harrisonhsueh/Buck_Boost_42W/uvlo/uvlo_latch.pdf

## UVLO Lockout Latch (rev. v3b): Discrete Pre-Bias Restart Protection for the LM5176 Buck-Boost

USB-C PD → 12 V Fan-Array Controller — Buck-Boost 42W

Abstract

A four-BJT + TLV431 latch that pulls the LM5176 EN/UVLO pin low on an input dropout and, because it is powered from VOUT , holds it low until the output has discharged (release at ≈1.0–1.8 V across unit tails), forcing every restart to begin from a nearly dead output. Rev. v3b uses a ratio-defined trigger — v3’s trigger depended on unspecified sub-threshold leakage; this one only on resistor ratios and spec’d VBE, so it is consistent across part spread. The SCR core is armed by a resistor divider (arm at 2.8 V nominal, i.e. box-center VBE; guaranteed range 2.0–3.6 V) and held off by an actively driven dearm transistor while the TLV431 senses a healthy input (dearm active from 2.05 V worst case, 27 mV of headroom above the 2.02 V physics floor). All device spreads are taken from the datasheet-box VBE model (traceable to the VBE(sat) spec), and the dearm-before-arm race is guaranteed by those spec limits alone at every temperature. Companion files: 10b uvlo latch.py (all checks below, executable), uvlo tlv431.tex/10a (EN/UVLO divider), simulation/en uvlo lockoutv3 tlv.asc.

## 1 Background

The LM5176’s pre-bias startup does not survive a brief input dropout in this design (deliberately slow control loop; TI support could not root-cause it). The latch disables the converter on dropout and re-enables it only once the output is discharged. Rev. v3 used Q3’s sub-threshold leakage as the engage seed; the required nA-level current is unspecified and spans orders of magnitude across the 2N3904 spread and temperature. v3b moves the trigger onto resistor ratios and spec’d VBE — robust and consistent by construction.

## 2 The VBE model (datasheet box, used everywhere below)

Anchor: the 2N3904/2N3906 VBE(sat) spec at IC = 10 mA, IB = 1 mA, 25 ◦C: 0.65 (min) .. 0.85 (max) V. The latch junctions operate near 30 µA, so the anchor is scaled by the diode law VBE = nVT ln(IC/IS) (n ≈ 1), whose difference form removes the unknown IS:

VBE(I1) − VBE(I2) = VT ln I1
I2

⇒ ∆VBE = 25.9 mV · ln 10 mA 30 µA

= 25.9 × 5.81 = 150 mV,

V

lo

BE(30 µA) = 0.65 − 0.15 = 0.50 V, V hi BE(30 µA) = 0.85 − 0.15 = 0.70 V (25 ◦C),

with the −2 mV/

◦C tempco applied for temperature (0–50 ◦C design range: e.g. V
hi
BE(0 ) = 0.75,
V

lo
BE(50 ) = 0.45). Conservatism note: VBE(sat) is a saturation measurement (both junctions forward, base overdriven) and includes the ohmic drop rbIB — small-signal base spreading resistance is typically rb ≈ 10–100 Ω, i.e. 10–100 mV at the IB = 1 mA test condition — neither of which exists at 30 µA. The true active-mode box is therefore narrower; using the spec box as-is is the safe, traceable reading.
Other model values: VCE,sat = 0.1 (max 0.2) V; βmin = 30; V

off
BE = 0.4 V (design bound; “off” is defined quantitatively in step 2 — leak ≪ hold drive — not as zero); VKA = 1.24 (max 1.27) V — the latch’s worst case is the max, since it sets the dearm floor; the corresponding min is 1.193 V once the full onsemi VKA excursion is folded in (uvlo tlv431.tex), which is what the divider search uses; TLV431 (onsemi): IK(off) ≤ 0.05 µA, I

reg
KA 30 µA typ / 80 µA max, I

max
K = 20 mA;
resistors ±3% (1% purchase + 100 ppm/

◦C tempco + load-life/soldering drift); VOUT = 12 nom / 15.75 max (15 V zener +5%); V

max
IN = 22 V. EN/UVLO divider (sized in uvlo tlv431.tex): R2/R1a/R1b = 420/150/15 kΩ.

## 3 Circuit and chosen values


The latch is the left block; the EN/UVLO divider it senses (and clamps) is on the right, sized in uvlo tlv431.tex.

Ref | Value (bound → chosen) | Connection | Role
Q1 | 2N3904 | c: EN/UVLO, b: N5, e: GND | EN clamp
Q2 | 2N3906 | e: VOUT , b: VB2, c: N1 | dearm driver
Q3 | 2N3904 | c: N4, b: VB3, e: GND | core NPN (armed switch)
Q4 | 2N3906 | e: VOUT , b: VB4, c: VB1 | core PNP
R3 | race-solved ≤ 135k → 130 kΩ | VB3–GND | arm divider bottom
R4 | 300 kΩ (free choice) | VOUT –VB3 | arm top / Q3 drive
R5 | ≥ 51R6 → 82 kΩ | VB4–N4 | Q3 pulls Q4 base
R6 | 1 kΩ | N1–VB4 | Q2 pulls Q4 base up
R7 | 30 kΩ | VB1–VB3 | regeneration
R8 | tier choice (step 2) → 2 MΩ | K–GND | TLV431 cathode load
R9 | window (step 1) → 1.5 kΩ = 2×3 kΩ ∥ (0603 pair) VB2–K | Q2 base ← cathode
R10 | ≤∼ 49k solved (step 2) → 47 kΩ | VOUT –VB2 | Q2 base pull-up
R11 | 100 kΩ | N5–GND | Q1 base divider bottom
R12 | 100 kΩ | VB1–N5 | Q1 base divider top
U1 | TLV431 (onsemi only) | A: GND, K, REF: divider VREF | sensor

Q3/Q4 with R5/R7 form the two-transistor SCR; Q1’s base is driven from Q4’s collector through
R12/R11, so before the latch fires its base sits at a defined sub-threshold level (0.33 V, Stage 4) rather than floating on leakage.

## 4 Design walkthrough (sizing order, worked numbers)

### 4.1 Stage 1: R10, R9, R8 — TLV431 sensing and the Q2 dearm driver

Constraint set. With the TLV431 regulating (K clamped at VKA), Q2’s base drive is

| IB2 = VOUT − VKA − VEB2
| R9

−

| VEB2
| R10

≥ I

req
B2 ≈ 1.1 µA | ⇐⇒ | R10 ≥
| | VEB2 R9
| | h − R9 I req
| | B2
| | , | (1)

with h = VOUT − V

| max
KA − VEB2 the drive headroom; and with the TLV431 off,
| V res
| EB2 = V max
| OUT R10
| R8 + R9 + R10 | + IK(off)R10 ≤ V off
| | BE = 0.4 V. | (2)

With VEB2 = V

| hi BE(0 ) = 0.75 V, the physics floor is V

max
| | KA + VEB2 = 1.27 + 0.75 = 2.02 V.
Step 1: R9 from its independent bounds. R9 carries the full cathode current whenever the converter runs, IK = (VOUT − VEB2 − VKA)/R9, which is also the TLV431 regulation current:

IK ≤ 20 mA at 15.75 V : R9 ≥

| 13.81
20m = 0.69 kΩ; | IKA ≥ 80 µA at the box worst-low arm (1.98 V, step 3) : R9 ≤

Power: a single 0805 would demand R9 ≥ 13.81²/0.125 = 1.53 kΩ, above the IKA bound: no single resistor works. Build R9 = 1.5 kΩ as two 3 kΩ basic 0603s in parallel — each part carries half the current (34 mW continuous / 64 mW at the OV corner vs. 100 mW rating). IKA razor: even 1.5 k reads 61 µA nominal / 59 µA at R9+3% at the box-corner arm point vs the 80 µA max-of-min — reaching spec would need R9 ≤ 1.1 k, i.e. a 4-resistor array. Accepted: the shortfall exists only at the full R-corner + hot + low-tail stack, fails soft (under-regulation raises K while VOUT and IKA keep rising), and typical parts need 30 µA. Bench item for the startup ramp. Why not smaller R9 (the headroom question):

R9 | dearm active | IK@12 V | IK@15.75 V | PR9 tot @12/15.75 V | verdict
1.5 k (2×3k∥) | 2.047 V | 6.7 mA | 9.2 mA | 67/127 mW (34/64 per part) chosen
1.0 k (2×2k∥) | 2.038 V | 10.1 mA | 13.8 mA | 101/191 mW | buys 9 mV, IKA 91 µA
0.5 k | 2.029 V | 20.1 mA | 27.6 mA | 202/381 mW | exceeds 20 mA rating
0.1 k | 2.022 V | 101 mA | 138 mA | 1.0/1.9W | 7× over rating
Step 2: pick the R8 tier, then SOLVE Rmax
10 from (2). (1) and (2) pull R10 oppositely: larger R10 lowers the dearm point (less bleed) but inflates the off-state residual, bought back with larger R8. The leakage term alone would allow R10 up to 0.4/0.05 µA = 8 MΩ — nowhere near binding; the divider term of (2) is what sets the bound. Basic-part R8 above 510 k comes only in 1 M, 2 M, 10 M, so fix the tier and solve for R10 (corners R10+3%, R8, R9−3%):
R8 tier | Rmax
10 | solved | basic pick | dearm active | hot ICBO(100 nA)·R10
2 M | ∼49 kΩ | 47 k | 2.047 V | 4.7 mV
10 M | ∼230 kΩ | 220 k | 2.027 V | 22 mV

With IK(off) = 50 nA the leakage term is negligible (47k×50 nA = 2.4 mV); the bound is the divider alone. The 10 M tier buys 20 mV (asymptote 2.02 V) while quintupling ICBO/board-leakage sensi-tivity — rejected. Chosen: R8 = 2 MΩ, R10 = 47 kΩ. Verify (2) at corners (R10+3%, R8, R9−3%): 15.75 ·

48.4k
1.99M + 50n · 47k = 0.383 + 0.002 = 0.386 V ≤ 0.40 V ✓. What “off ” means, quantitatively: at that residual, a box-worst (low-tail, 50 ◦C) Q2 still leaks IC2 = 30 µA · e

(0.386−0.45)/VT = 3.0 µA
— but the latch’s VB4 hold drive at the same corner is 183 µA, so the leak is 1.6% of the hold: “off” means negligible against the hold, not zero. The resulting worst-case dearm-active point: bleed = 0.75/45.6k = 16.4 µA, h = 1.545k · (16.4+1.1) µA = 27 mV ⇒ VOUT = 2.05 V (a solved result, not a target; its only requirement is the race, step 3).

### 4.2 Stage 2 (step 3): R4, R3 — the arm threshold and the race

With Q4 off, VB3 is loaded by R3 ∥ (R7+R12+R11): Reff
| | | 3 | = 130∥230 = 83.1 kΩ, so
Varm = VBE(︂ 1+ | R4
| Reff
| 3

)︂
: | V
| mid
arm = 0.60·4.61 = 2.77 V, | V min
arm = 0.45·4.40 = 1.98 V, | V max
arm = 0.75·4.84 = 3.63 V,

(3)
the ratio 1 + R4/Reff
3 being evaluated at the ±3% resistor corners (4.40 / 4.61 / 4.84). R3 is solved from the race requirement: dearm-active(T) ≤ V

min
arm (T) at every temperature, with Q2 at the box high tail and Q3 at the box low tail simultaneously. The binding corner is 50 ◦C: V

min
arm ≥ 1.27 + V

hi
BE(50) + h = 1.94 V ⇒ R3 ≤ 135 kΩ → 130 kΩ basic. Margins:

race margin = V

min
arm (T) − dearm(T) = 374 mV (0 ), 205 mV (25 ), 37 mV (50 binding).

Guaranteed by the datasheet box alone — no unit screening required. Q3 drive once armed: IB3 = (VOUT − Varm)/R4 ≈ (12 − 2.77)/300k = 31 µA against the 142 µA dearm-chain load: forced β = 4.6 ≤ 10.

### 4.3 Stage 3 (step 4): R5, R6, R7 — the VB4 fight and regeneration

Dearmed (Q2 and Q3 both on): the chain VOUT → Q2 → R6 → R5 → Q3 →GND carries I = (VOUT −2VCE)/(R5+R6); VB4 sits below VOUT by VCE2+IR6. At 15.75 V: I = 15.55/83k = 187 µA, so VOUT − VB4 = 0.1 + 0.187 = 0.29 V ≤ 0.40 V ✓(this is where R5 ≥ 51R6 comes from). Latched at the 2 V hold floor (cold tails: drive junctions at V

hi
BE(0) = 0.75, loads at V

lo
BE(0) = 0.55):
IB4 = (2−0.75−0.1)/82k = 14.0 µA; IC4 = (1.9−0.55)(1/30k+1/100k) = 58.5 µA: forced β = 4.2. Regeneration: IB3 = (1.9−0.75)/30k + (2−0.75)/300k − 0.75/130k = 38.3+4.2−5.8 = 36.7 µA against a 14 µA load.

### 4.4 Stage 4 (step 5): R12, R11 — the Q1 EN clamp

Off before the latch fires: VN5 = V

hi
BE(0)·R11/(R7+R12+R11) = 0.75·100/230 = 0.33 V, below even a hot low-tail unit’s 0.45 V conduction. Clamp at the 2 V hold floor: IB1 = (1.9 − 0.75)/100k − 0.75/100k = 4.0 µA against the requirement IEN /βmin = 57.6 µA/30 = 1.9 µA: margin 2.1×. Release, solving IB1 = IEN /β:

V

rel

OUT = VCE4 + VBE + R12(︂IEN
β

+

VBE

R11

)︂
= 1.05 V (V

lo
BE, VIN =6) . . . 1.79 V (V

hi
BE, VIN =22). (4)

Hold guaranteed at 2.0 V; actual release 1.0–1.8 V by unit; the SCR core itself un-latches near 0.8 V.

## 5 Operating sequence (summary)

1. Cold start: VOUT = 0, latch unpowered, Q1 base defined low.
2. VOUT rises: dearm active from 2.05 V (worst), arm at 2.0–3.6 V; dearm wins by ≥37 mV at any single temperature, guaranteed by the datasheet box.
3. Dropout with VOUT > Varm: TLV off → Q2 off → Q3 wins VB4 → Q4 on → Q1 clamps EN; R7 regenerates.
4. EN low ⇒ VREF ≤ 0.19 V ≪ VTLV: hold is VIN -proof.
5. VOUT decays; EN releases at 1.0–1.8 V; clean restart.

Accepted gap. A dropout while VOUT is between release (1.0–1.8 V) and that unit’s arm point (2.0–3.6 V) does not latch. More precisely: the latch cannot act anywhere below its arm point, so the unprotected region is VOUT < Varm — it extends down to zero, not merely to the release point. (The release point governs when an already engaged latch lets go; it is not a lower bound on the exposure.)
Two qualifications matter. First, body diodes do not bound it: the LM5176 switches syn-chronously, so an enabled FET conducts in either direction. Second — and this is the part that makes the exposure a safety question — a stored-energy argument does not bound it. A passive dump through a conducting FET would simply equalise the two banks at VOUT COUT /(COUT+CIN ) = 3.56 V, which is harmless. But a buck-boost transfers energy through its inductor, and the input bank is 90× smaller (COUT ≈ 18.9 mF vs. CIN ≈ 0.21 mF), so any reverse transfer is a boost into a small capacitor:
VIN ≈ VOUT√︃
COUT

CIN

= 3.6 × 9.5 ≈ 34 V, | (5)

against a 22 V operating maximum and 35 V input electrolytics — with the attached USB source seeing the same rail. Even a quarter of the energy arriving gives ≈ 17 V.
Open item (safety). Confirm by bench and simulation that the LM5176’s pre-biased startup performs no reverse energy transfer for VOUT below the arm point. Until that is shown the low-VOUT band is an accepted, documented exposure; the case for extending protection below the arm point — or for clamping the input — rests on that measurement.

## 6 TLV431 vendor constraint

Eliminating the resistors from (1)/(2) gives the floor V

worst
K | ≥ V

max
OUT −

V

off
BE
VEB2

(Vdearm − VKA) =
15.75 −

0.4
0.75 (2.05 − 1.24) = 15.3 V; the chosen divider gives 15.75 · 2M/2.05M = 15.4 V. Holding VK ≤ 6 V is therefore impossible at any useful dearm point, which is why the design assumes the onsemi TLV431 (V

max
KA = 16 V) rather than the pin-compatible TI part. The 15.4 V figure is itself a double-fault corner: K only floats high while the latch is engaged, and in that state VOUT is decaying from ≈12.6 V, giving a realistic VK ≈ 12.4 V.

## 7 Quiescent draw

Dearmed at 12 V: R9 chain 12−0.7−1.24
1.5k = 6.7 mA + R10 15 µA + R5+R6 142 µA + R4 31 µA ≈ 6.9 mA (≈ 83 mW). Each 3 k of the R9 pair dissipates 34 mW continuous / 64 mW at the OV corner (0603-safe). This is the price of the 2.05 V dearm point.

## 8 Verification status

10b uvlo latch.py runs the above as 21 worst-case checks: 0 FAIL, 2 WARN (the 59–61 µA IKA razor of step 1, and the onsemi-only vendor note), and parses the latest .raw.
The current LTspice transient (schematic at R3 = 130k, R5 = 82k, R8 = 2M, R9 = 2.2k, R10 = 39k, EN/UVLO divider already at the recommended 420/150/15 kΩ, plus a behavioural EN-pin current source: 0.2 µA below threshold, 3.15 µA enabled) confirms the full sequence:
- Arm: VB3 clamps at 0.64 V — Q3 on, core armed.
- Engage: EN clamps at VIN = 3.47 V vs. 3.51 V predicted from the divider equation at VTLV = 1.24, IS = 3.15 µA (1.3 % error).
- Hold: EN ≤ 10 mV through a full VIN re-application at VOUT = 12 V.
- Release: at VOUT = 1.08 V, inside the predicted 1.0–1.8 V band.
- Dearmed: VREF = 1.88 V while running (> VTLV = 1.24 V), i.e. the TLV431 conducts throughout normal operation as C2/C3 require.
The simulated circuit still carries two intermediate values, R9 = 2.2 kΩ (vs. the 1.5 kΩ of the 2×3 k pair) and R10 = 39 kΩ (vs. 47 kΩ). Both final values only lower the worst-case dearm point (2.09 → 2.05 V), so the sequence above is representative of the final design.
