harrisonhsueh/Buck_Boost_42W/uvlo/uvlo_tlv431.pdf

## LM5176 EN/UVLO Threshold with TLV431 Latch: Equations, Ranges, and Design Constraints

USB-C PD → 12 V Fan-Array Controller — Buck-Boost 42W

Abstract

This document derives the equations and worst-case design constraints for the three-resistor EN/UVLO divider that feeds both the LM5176 enable pin and the TLV431 reference of the external lockout latch. It is the analytical companion to 10a uvlo resistor search.py, which searches stocked resistor values against these constraints. The latch circuit itself is documented in uvlo latch.tex / 10b uvlo latch.py.
Result: R2/R1a/R1b = 420/150/15 kΩ (R2 = 120 k + 300 k in series), guaranteed turn-on band 2.75–4.49 V, per-unit gaps 52/41 mV.

## 1 Motivation: why an external lockout latch

The LM5176 advertises pre-biased startup, but in this design it does not survive an input dropout in practice. The control loop is deliberately slow (low crossover frequency, chosen so the loop does not react to the fan commutation pulses — see the stability notebook), and with that loop the part misbehaves when VIN recovers while the output capacitors are still charged: the restart into a pre-biased output is not handled cleanly. TI support was unable to root-cause the failure; their only suggestion was to raise the crossover frequency, which is ruled out by the system requirement that set the low crossover in the first place — the loop must not chase the fan commutation pulses, so raising its bandwidth would trade one problem for another.
The chosen fix is a small discrete latch: on an input dropout it pulls EN/UVLO low and, because it is powered from VOUT , it holds EN/UVLO low until the output has actually discharged. Every restart therefore begins from a nearly dead output and the pre-bias path is never exercised. This document sizes the divider that tells the latch when to fire; the latch itself is in uvlo latch.tex.

## 2 Circuit topology and conventions

A single node, EN/UVLO (voltage VEN), is driven from VIN through R2. A two–element lower leg returns to ground: R1b connects EN/UVLO to the TLV431 reference node (voltage VREF), and R1a connects that reference node to ground. The TLV431 REF pin sits on the VREF node and draws a bias current Iref into the pin.


(Left block: the lockout latch of uvlo latch.tex; right: the R2/R1b/R1a divider on the EN/UVLO pin with the behavioural EN-current source used in simulation.)

Current–source convention (LM5176). Per the datasheet, the LM5176 sources current out of the EN/UVLO pin into the node: ISTBY in standby, plus an additional IHYS once the operating (UVLO) threshold is crossed, which lifts VEN and creates the turn-on/turn-off hysteresis. The total injected current is

IS = ISTBY + IH, IH =

{︄
| | 0 | standby (rising, before turn-on)
| | IHYS | running (after turn-on)

## 3 Parameter ranges

Symbol | Min | Max | Notes
VIN | 4.5 V | 22 V | USB input
VEN,th (operating) | 1.17 V | 1.29 V | LM5176 EN/UVLO operating threshold
ISTBY | 1 µA | 3 µA | standby source current
IHYS | 2.15 µA | 4.25 µA | added after turn-on
Iref | 0 µA | 0.38 µA | TLV431 REF input current
VTLV | 1.193 V | 1.266 V | effective TLV431 reference (see below)
Resistors | ±3% | budget-derived; see below

Effective TLV431 reference VTLV. Built up from the nominal 1.24 V:

V

max
TLV = 1.240 + 0.0062
⏞ ⏟⏟ ⏞
+0.5%

+ 0.020
⏞ ⏟⏟ ⏞
temp

= 1.266 V, V min
TLV = 1.240 − 0.0062
| | | ⏞ ⏟⏟ ⏞ −0.5% − 0.020 ⏞ ⏟⏟ ⏞ temp − 0.021 ⏞ ⏟⏟ ⏞ VKA effect = 1.193 V.

The VKA term uses the datasheet reference shift ≈ −1.5 mV/V across the cathode excursion. The cathode floats to ≈ 15.4 V once the latch fires (see uvlo latch.tex), so the shift spans 1.24 →

15.4 V: 1.5 mV/V × 14.2 V ≈ 21 mV. The term only shifts the reference down, so it appears in the min only.
This excursion also drove the choice of vendor: the reference sees the full ≈ 15.4 V on its cathode whenever the latch is engaged, so a part rated to only 6 V on VKA (the TI TLV431) would be outside its absolute maximum in normal operation of this circuit. The onsemi TLV431, rated 16 V, is the part assumed throughout — the two are otherwise pin- and function-compatible, which makes this an easy substitution to get wrong.

Resistor tolerance budget. ±3% everywhere: 1% purchase tolerance + ∼0.4% tempco (100 ppm/

◦C
over the 0–50◦C range) + ∼1.5% load-life and soldering drift.

## 4 Node equations (KCL)

EN/UVLO node.
VIN − VEN
R2

+ IS =

VEN − VREF

R1b

(1)

REF node.
VEN − VREF

R1b

=

VREF

R1a

+ Iref | (2)

## 5 Closed-form solutions

Solving (1)–(2):

VEN =

VIN (R1a + R1b) + IS R2(R1a + R1b) − Iref R1a R2
R1a + R1b + R2

(3)

VREF =

R1a (VEN − Iref R1b)

R1a + R1b

(4)

TLV431 trip relation (the key design lever). The map between VEN and VREF depends only on the lower leg, independent of VIN , R2, and the EN-pin currents:

VEN = VREF

R1a + R1b

R1a

+ Iref R1b | =⇒ | VEN

⃓
⃓

trip = VTLV

R1a + R1b

R1a

+ Iref R1b | (5)

at the instant VREF = VTLV.

Inverting (3) for VIN . For any target VEN in a given state,

VIN =

VEN(R1a + R1b + R2) − IS R2(R1a + R1b) + Iref R1a R2

| | R1a + R1b
. | (6)

## 6 Latch behavior and the three threshold events

The external latch is powered from VOUT and defaults to engaged: it is held off (dearmed) only while VREF > VTLV. There is no “arm-after-first-release” grace — whenever VREF sits below VTLV with the converter running and VOUT above the latch’s arm threshold (≈ 2.8 V nominal; see uvlo latch.tex), the latch grabs and pulls EN/UVLO low, holding until VOUT has decayed (≈1–1.8 V release). The divider must therefore keep the TLV431 conducting throughout normal operation.
1. VIN rises; VEN (standby, IS = ISTBY) reaches VEN,th: LM5176 turns on.
2. IHYS switches in ⇒ VEN, hence VREF, jumps up. Because the design forces Vlatch < Von (constraint C2), VREF is already above VTLV at this instant: the latch is dearmed at turn-on, even on an arbitrarily slow rise.
3. VIN falls. While running, VREF falls; when it drops below VTLV the latch engages before the LM5176 would reach VEN,th on its own (constraint C3).

Event definitions. All three events are values of VIN , each defined by (6) with the VEN level and EN-pin current of its own operating state:

Event | VIN at which. . . | IS | state
Von | VEN = VEN,th | ISTBY | standby, rising (turn-on)
Vlatch | VEN = VEN|trip | ISTBY + IHYS | running, falling (TLV431 trip)
Voff | VEN = VEN,th | ISTBY + IHYS | running, falling (LM5176 self-dropout)

The required ordering, for every individual unit, is

Voff < Vlatch < Von. | (7)

Note the chain deliberately mixes states: Von uses the standby current because that is the state the part is actually in as VIN rises; the moment the threshold is crossed, IHYS engages and VEN jumps upward (the equivalent running-state crossing is Voff, lower by the hysteresis), so comparing Vlatch (a running event) against the standby Von is the correct and conservative form for the turn-on race.

Equivalent chain in VREF. Because running-state VREF is monotonic in VIN , (7) is equivalent to bracketing the TLV431 reference between the running-state VREF levels at the two LM5176 events:

R1a(VEN,th − IrefR1b)

R1a + R1b
⏞ | ⏟⏟ | ⏞
| V run
REF at Voff

< VTLV < V run
REF at Von, | (8)

i.e. the TLV431 must still be conducting when the LM5176 would drop out (left), and must be conducting from the moment IHYS engages at turn-on (right) — the requirement begins once IHYS lifts the running-state VREF, which happens as (or just before) the converter starts switching.

## 7 Design constraints (worst case)

Each must hold across the ±3% resistor tolerance and every chip-parameter extreme of the table above.

C1 — Guaranteed turn-on by 4.5 V. In standby,

min VEN(︁
VIN =4.5, IS=I

min

STBY, Imax
ref )︁
≥ V

max
EN,th = 1.29 V. | (9)

C2 — Latch dearmed below turn-on (per-unit).

min
corners

(︁

Von − Vlatch)︁
≥ 0. | (10)

We require Von > Vlatch so that no band exists in which the converter runs while VREF < VTLV (such a band would let the default-engaged latch grab during a slow start). Like C3, (10) is a per-unit (correlated) difference — evaluated as one subtraction per device, never as a gap between independent population bands (Section 8).

C3 — Latch fires before the LM5176’s own UVLO (per-unit).

min
corners

(︁

Vlatch − Voff)︁
≥ 0. | (11)

C4 — Do not turn on too early. The worst-case earliest turn-on must stay above V

min
on ≥
2.5 V, so a not-yet-settled USB rail is not loaded and the converter is not asked to boost from an impractically low input. C4 fights C2: the large R2 that C2 demands, together with the 1 µA to 3 µA spread of ISTBY, smears turn-on across a ∼1.5 V band and drags the earliest turn-on down.

The hysteresis budget links C2 and C3. From (6), ∂VIN /∂IS = −R2 exactly, so the two VEN = VEN,th crossings, whose currents differ by IHYS, are separated by

Von − Voff = IHYS R2. | (12)

Subtracting (Vlatch − Voff) from both sides,

(︁

Von − Vlatch)︁
= IHYSR2 −

(︁

Vlatch − Voff)︁
(13)

— the two gaps share the single budget IHYSR2. A larger R2 widens the budget, and the VEN,th (±60 mV) and VTLV (+26/ − 47 mV about 1.24 V) spreads inflate the worst-case (Vlatch − Voff) gap by the factor (R1a + R1b + R2)/(R1a + R1b) (Section 8, Eq. (17)). Fitting that inflated gap inside the budget while leaving (Von − Vlatch) ≥ 0 is what forces R2 large — and a large R2 means a low, soft turn-on with divider current sinking toward the EN bias currents. The search rejects the bias-dominated region (divider current at turn-on below the total EN bias current) because there VEN becomes dominated by ISTBY/IHYS — currents with wide spec spreads and no drift specification — so the thresholds would smear with current spread rather than track VIN . The net effect is that all four constraints together are satisfiable only in a narrow design band — a real consequence of the part tolerances, not a modelling artifact.

Worked result (±3%, corrected V

min
TLV). Restricting the search to JLCPCB basic-part 0603 values, no triple of single stocked resistors clears all four constraints. Allowing R2 to be a series pair of two basic parts (one extra placement, still no extended-part fee) yields 19 passing triples. Selection criterion: the per-unit gaps are guaranteed positive by construction and need no extra margin, so among passing triples the search prefers the highest worst-case earliest turn-on V
| min on

— a higher Von floor eases the downstream latch’s dearm-before-arm race (SORT MODE="von min"). The best triple by that criterion is

R2 = 420 kΩ (120 kΩ + 300 kΩ series), | R1a = 150 kΩ, | R1b = 15 kΩ,

with V

min
on = 2.75 V, per-unit gaps min(Vlatch − Voff) = 52 mV, min(Von − Vlatch) = 41 mV, turn-on band 2.75 V to 4.49 V (C1, C4 met).

Reading the figures. Both figures are drawn in the (S, R2) plane with S ≡ R1a + R1b, at fixed R1a; every curve is the zero-margin locus of one constraint, obtained by setting that margin to zero in (6). C1 and C4 share a single form. Solving (6) at VEN = VEN,th for R2 gives the turn-on locus

R2 =

S

(︁

V − VEN,th)︁

VEN,th + IrefR1a − ISTBYS

(14)

with (V, ISTBY, VEN,th) = (VIN,on, Imin STBY, V max
EN,th) for C1 and (V

min

on , Imax
STBY, V min
EN,th) for C4.
This is not a straight line. It passes through the origin, but the denominator shrinks as S grows, so the curve steepens and diverges at the vertical asymptote

S∞ =

VEN,th + IrefR1a

ISTBY

, | (15)

the point at which the EN bias current alone holds the node at VEN,th and no R2 can delay turn-on further. For C1 (I

min

STBY = 1 µA) S∞ ≈ 1.35 MΩ — far outside the plot, so C1 looks gently curved; for C4 (I

max

STBY = 3 µA) S∞ ≈ 409 kΩ, inside the four-panel window, which is the steep upward sweep at its right-hand edge. The familiar straight-line approximation R2 ≈ S(V − VEN,th)/VEN,th is only valid while ISTBYS ≪ VEN,th — a 13 % error for C1 at S = 165 kΩ and 42 % for C4, which is why the plotted curves bend.
The other two boundaries:
C3 S ≥ R1a

(︁
V

max
EN,th − I

max
ref R1b

)︁

/V min
TLV — a vertical line, independent of R2, because the per-unit gap (17) factors into (VEN|trip −VEN,th), a function of the R1a/R1b ratio alone, times a positive scale factor.
C2 R2 ≥ ∆S/(I

min
HYSS − ∆) with ∆ = V

max
TLV S/R1a + I

max
ref R1b − V

min
EN,th — a hyperbola with its own vertical asymptote at S = ∆/IHYS.
At R1a = 150 kΩ, S = 165 kΩ these evaluate to R2 ≤ 448 kΩ (C1), R2 ≥ 300 kΩ (C4), R2 ≥ 298 kΩ (C2) and S ≥ 161.5 kΩ (C3) — the chosen 420/165 kΩ sits inside all four.

Equi-turn-on curves and the direction of improvement. Rearranging (6) the other way gives the earliest turn-on as an explicit function of the plot coordinates,

V

min
on = V

min
EN,th +

R2
S

(︂
V

min
EN,th + I

max
ref R1a − I

max
STBYS

)︂
, | (16)

whose level sets are exactly (14) at different V — so the equi-turn-on contours are members of the same curved family as C1 and C4 (which are just its 4.5 V and 2.5 V members), and they share C4’s 409 kΩ asymptote. The overlap figure overlays several of them (dashed grey, labelled in volts): the design improves by moving up-left onto a higher equi-turn-on curve, until that curve leaves the shaded feasible region — i.e. until it runs into the C1 ceiling. The chosen 420 kΩ is the highest available basic-part composite whose curve still clears C1 at the ±3% corners.
The soft, low turn-on band is the price of satisfying all four constraints at these tolerances. The star marks the chosen triple:

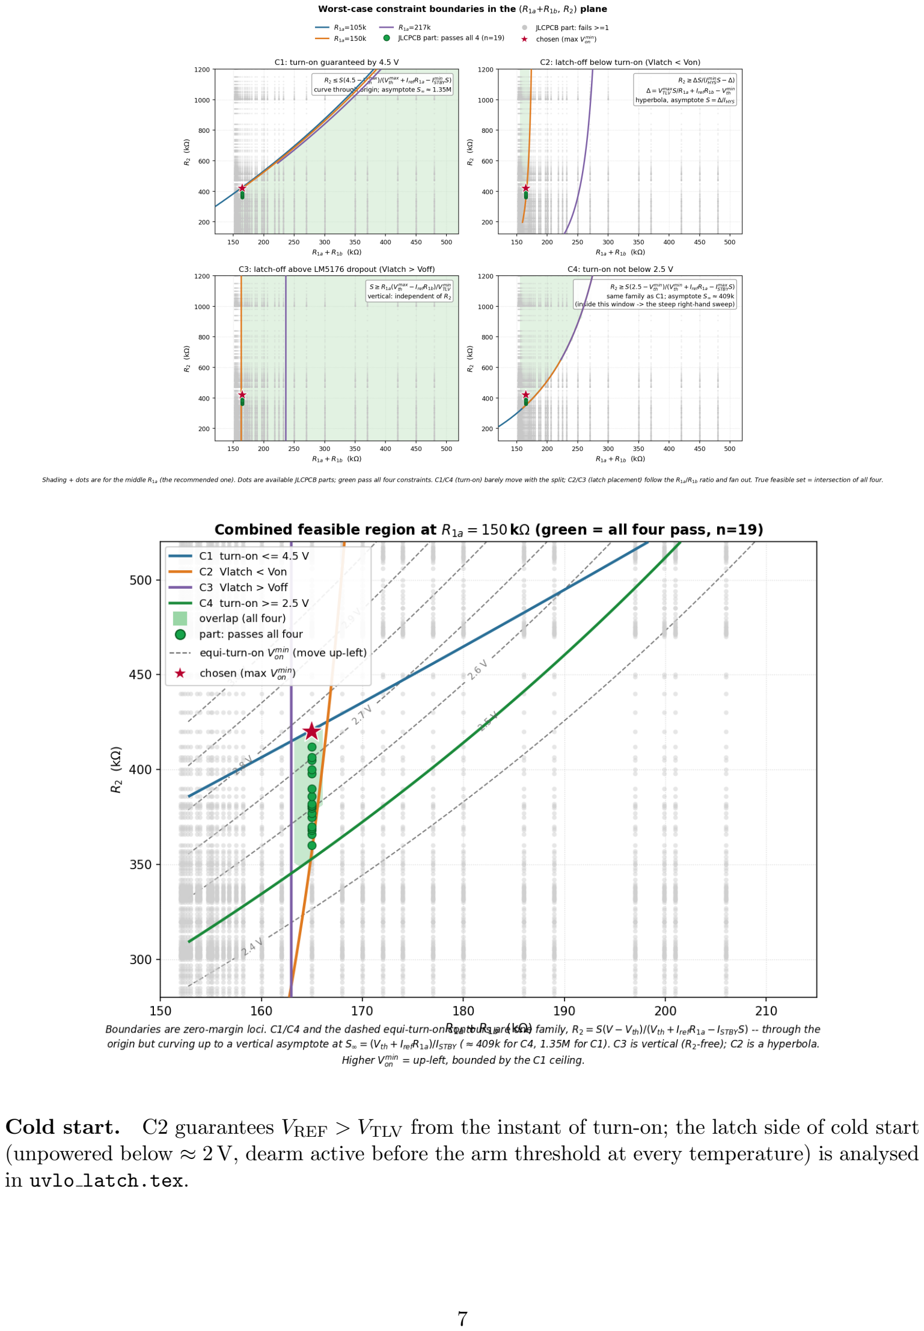
[picture p6: page 7]

Cold start. C2 guarantees VREF > VTLV from the instant of turn-on; the latch side of cold start (unpowered below ≈ 2 V, dearm active before the arm threshold at every temperature) is analysed in uvlo latch.tex.

## 8 Worst-case correlation: why the bands may overlap but units never do

It is tempting to compute the population span of each VIN event independently and compare the spans. That is too pessimistic for the latch-vs-dropout question.
Both the LM5176 self-dropout (VEN = VEN,th) and the TLV431 latch (VEN = VEN|trip) are running-state events of the same device at the same instant. They share the identical ISTBY, IHYS, VIN , and R2. Subtracting the two instances of (6) with a common IS and Iref,

Vlatch − Voff =

(︁

VEN|trip − VEN,th)︁ R1a + R1b + R2

R1a + R1b

(17)

and the bracket VEN|trip − VEN,th = VTLV(R1a + R1b)/R1a + IrefR1b − VEN,th contains no current term at all: ISTBY, IHYS, VIN , R2 have all cancelled. Driving IHYS to its maximum to lift Voff while simultaneously driving it to its minimum to drop Vlatch describes no physical unit.
The same caution applies to C2: (Von − Vlatch) is also a per-unit difference (shared Iref and resistors), and must be differenced per device, not read off the population bands. One caveat: C2’s two events happen at different times (turn-on vs. a later dropout), so the correlation additionally assumes each unit’s EN currents are stable between those moments; slow drift (e.g. temperature change between startup and the dropout) partially decorrelates C2. The C3 pair, evaluated at a single instant, has no such exposure. The accompanying script reports both the honest population bands (for visualisation) and the guaranteed per-unit gaps gap lo = min(Vlatch−Voff) and gap hi =

min(Von − Vlatch).

## 9 Simulation cross-check

simulation/en uvlo lockoutv3 tlv.asc now carries the recommended divider (420/150/15 kΩ) and injects the LM5176 EN-pin current via a behavioural source (0.2 µA below threshold, 3.15 µA enabled — the typical IHYS). Results:

Event | Simulated | Predicted | Basis
Engage (EN clamped) | 3.47 V | 3.51 V | (6), VTLV = 1.24, IS = 3.15 µA (1.3 % error)
VREF while running | 1.88 V | > VTLV | TLV431 conducting (C2/C3)
Hold through VIN return | EN ≤ 10 mV | latched | at VOUT = 12 V
Release | VOUT = 1.08 V | 1.0–1.8 V | latch doc, Stage 4

The 3.47 V engage sits inside the predicted Vlatch band and comfortably below the nominal turn-on, as C2 requires. 10b uvlo latch.py re-runs these cross-checks automatically against the latest .raw.

## 10 Symbol summary

R2 | top resistor, VIN →EN/UVLO
R1b | mid resistor, EN/UVLO→ VREF
R1a | bottom resistor, VREF → GND
VEN | EN/UVLO pin voltage
VREF | TLV431 reference-node voltage
VEN|trip | VEN when VREF = VTLV, Eq. (5)
Von, Voff, Vlatch | the three VIN events (table in Sec. 6)
