harrisonhsueh/Buck_Boost_42W/figures/combined_bode.png

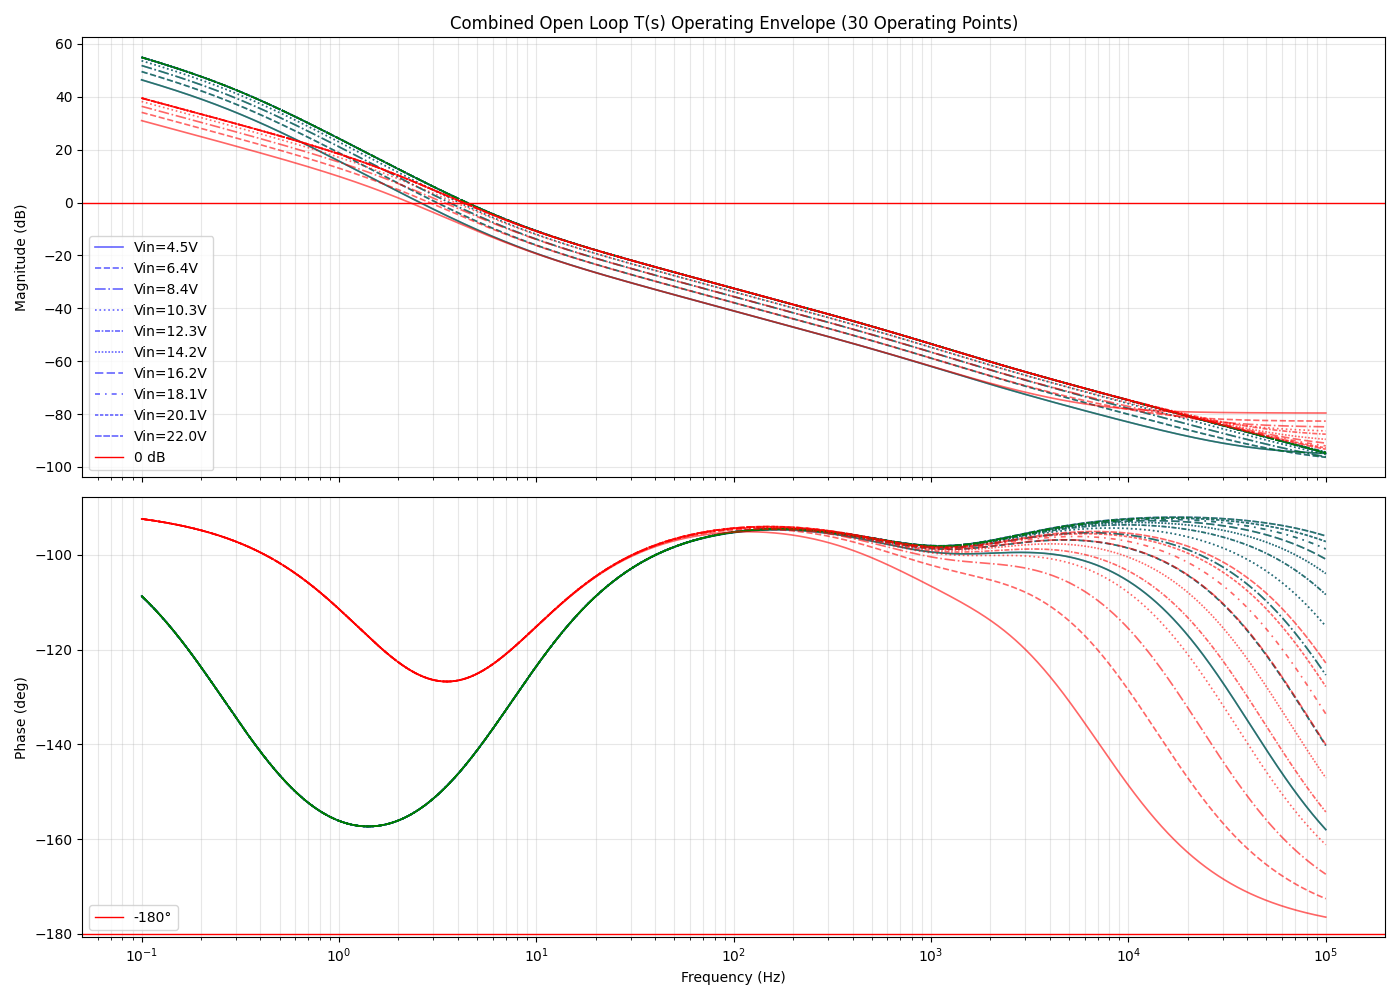
figures/combined_bode.png
