harrisonhsueh/Buck_Boost_42W/figures/combined_bode_boost.png

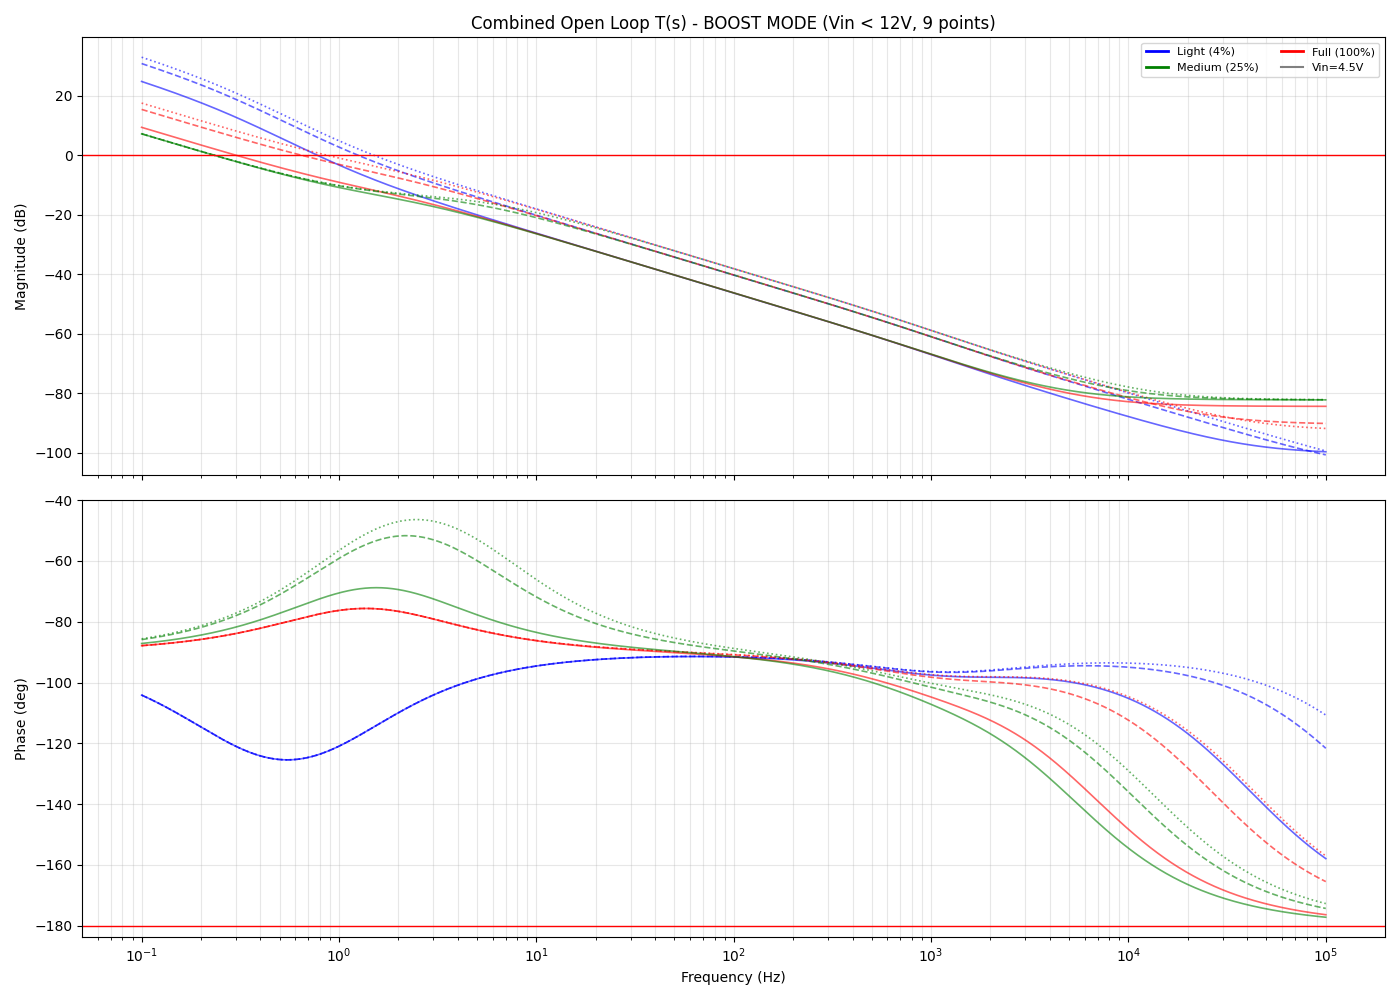
figures/combined_bode_boost.png
