harrisonhsueh/Buck_Boost_42W/figures/combined_bode_buck.png

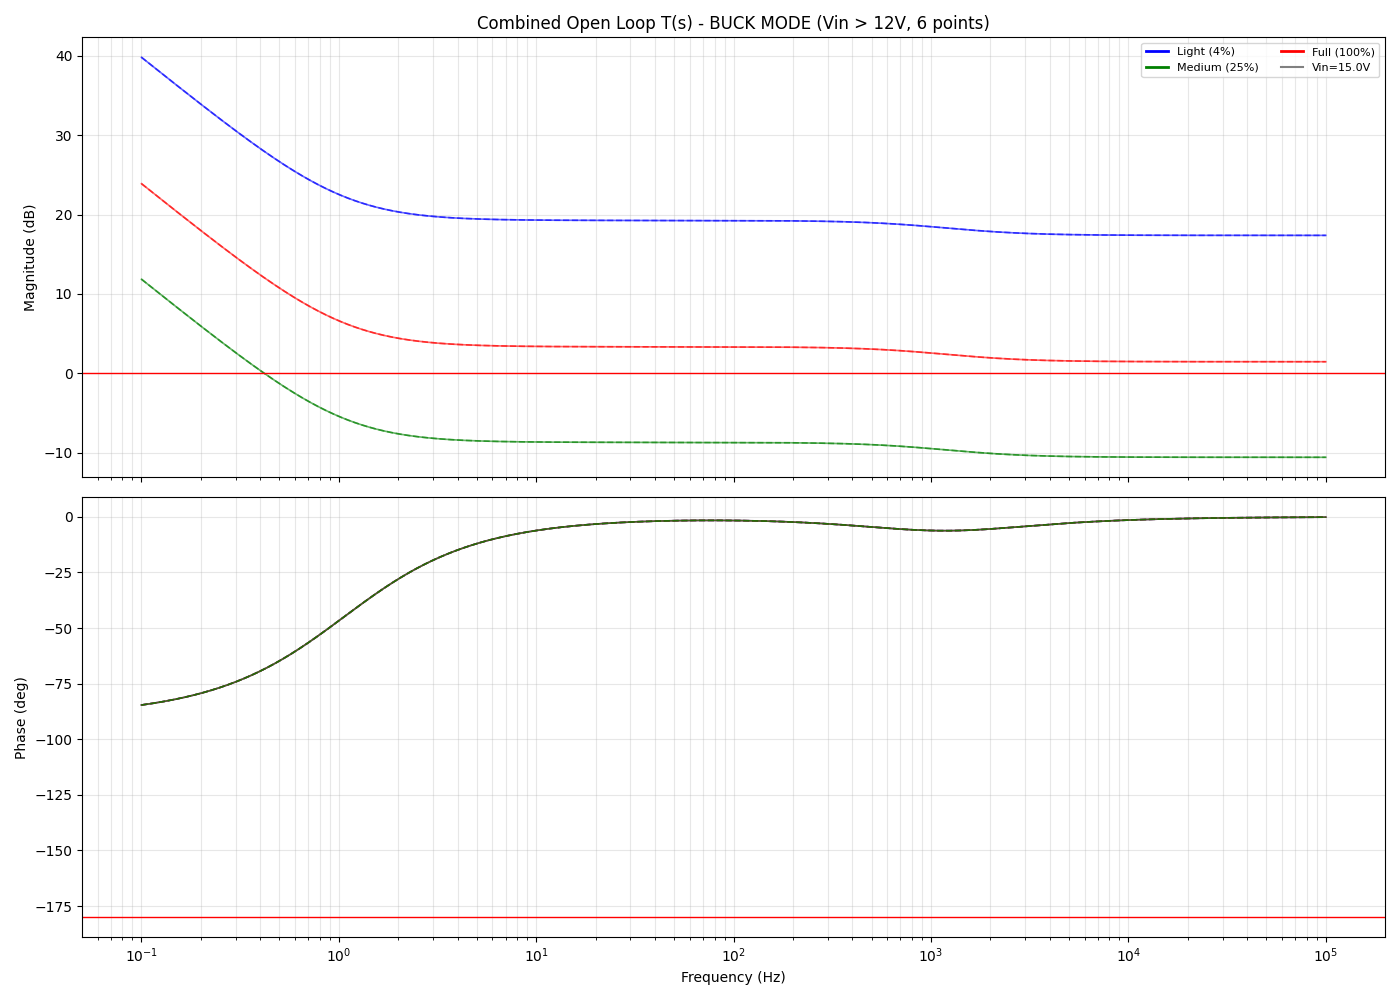
figures/combined_bode_buck.png
