harrisonhsueh/Buck_Boost_42W/figures/compensator_bode_plot.png

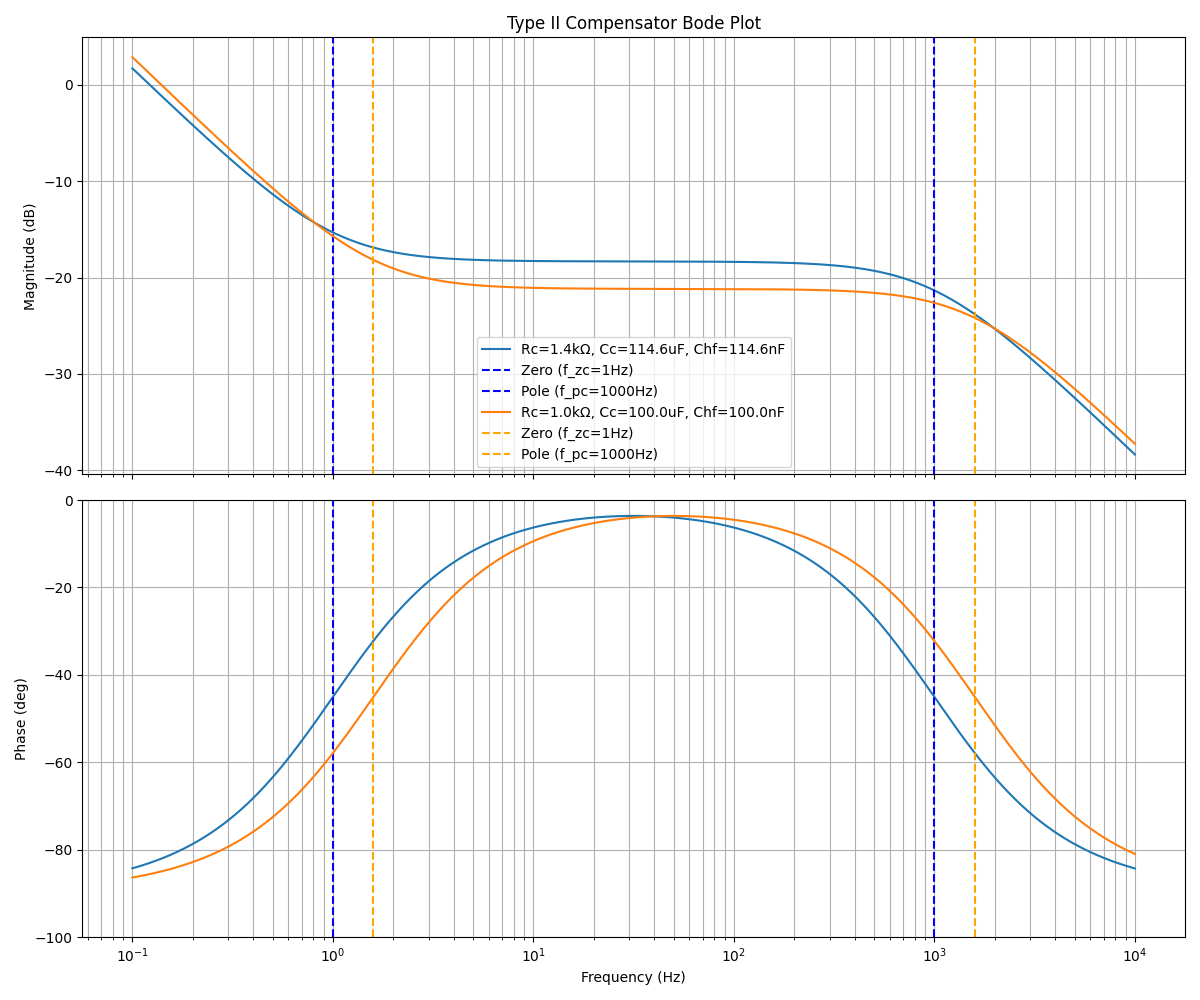
figures/compensator_bode_plot.png
