harrisonhsueh/Buck_Boost_42W/figures/efficiency_consolidated.png

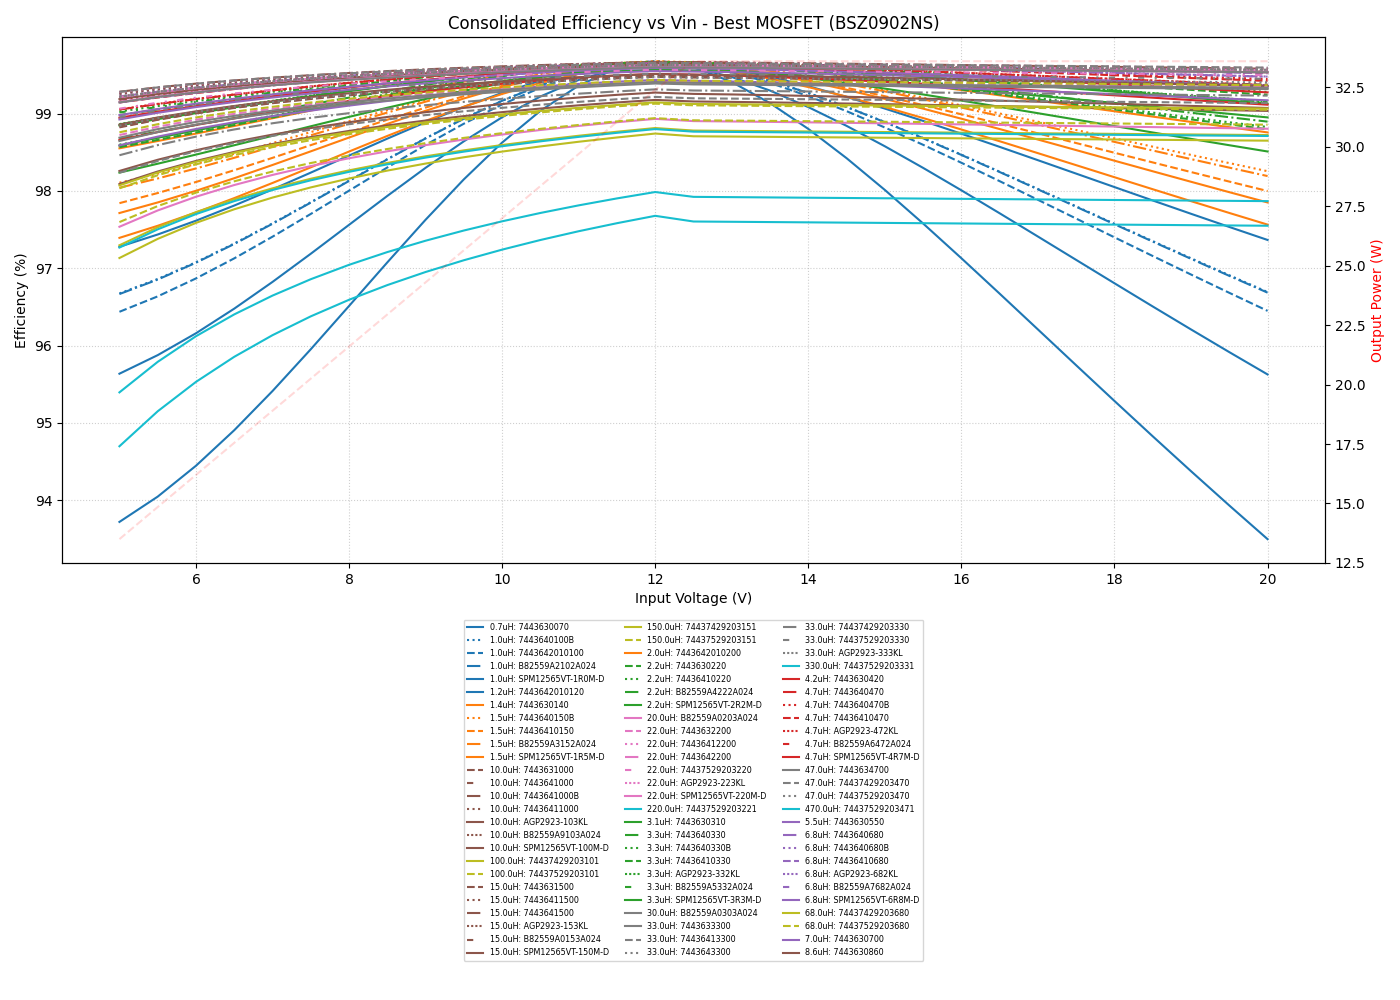
figures/efficiency_consolidated.png
