harrisonhsueh/Buck_Boost_42W/figures/loss_breakdown_5v.png

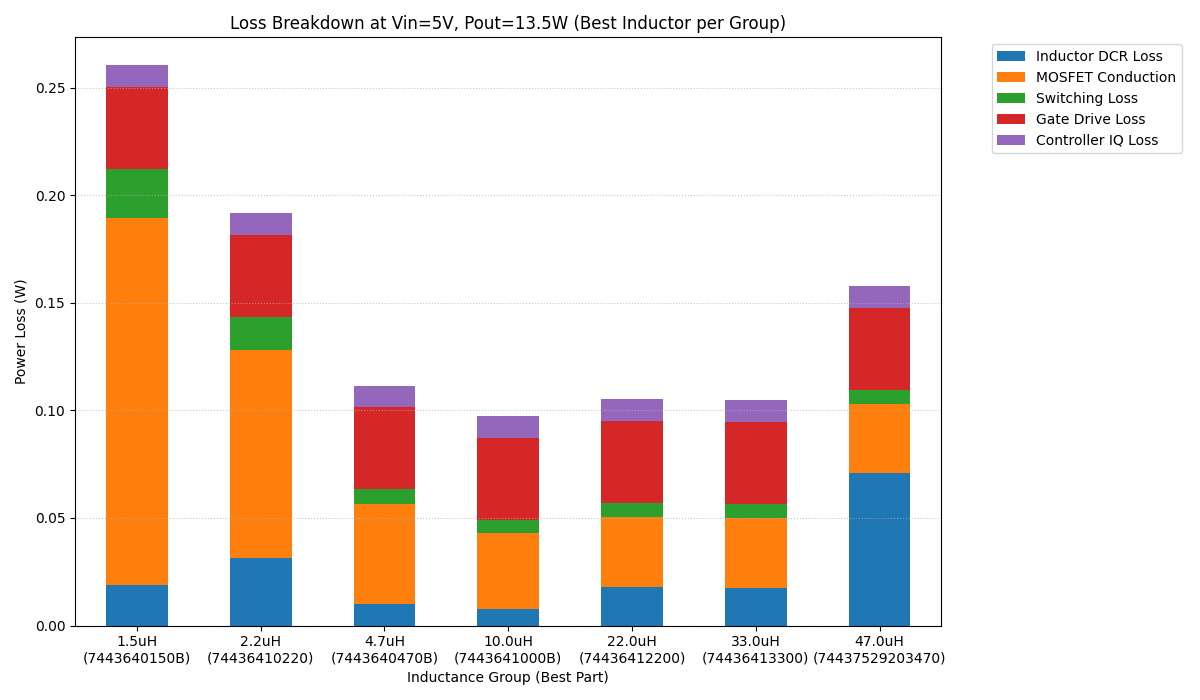
figures/loss_breakdown_5v.png
