harrisonhsueh/Buck_Boost_42W/figures/loss_breakdown_2920_round.png

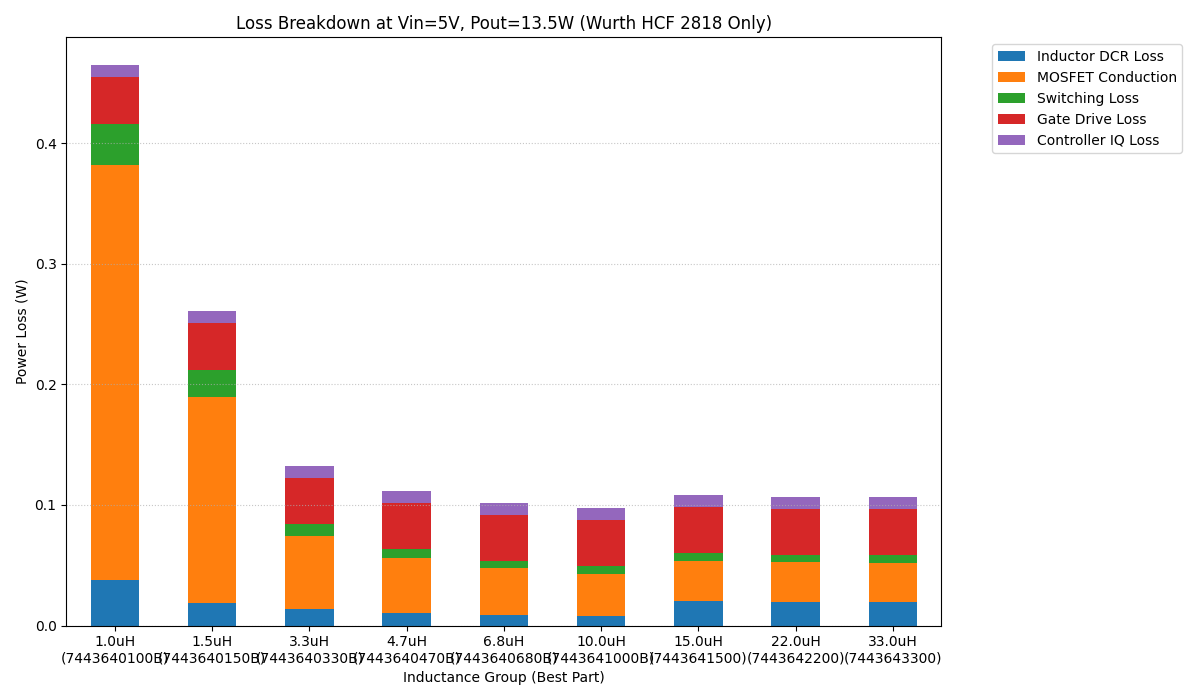
figures/loss_breakdown_2920_round.png
