harrisonhsueh/Buck_Boost_42W/figures/loss_breakdown_with_ac.png

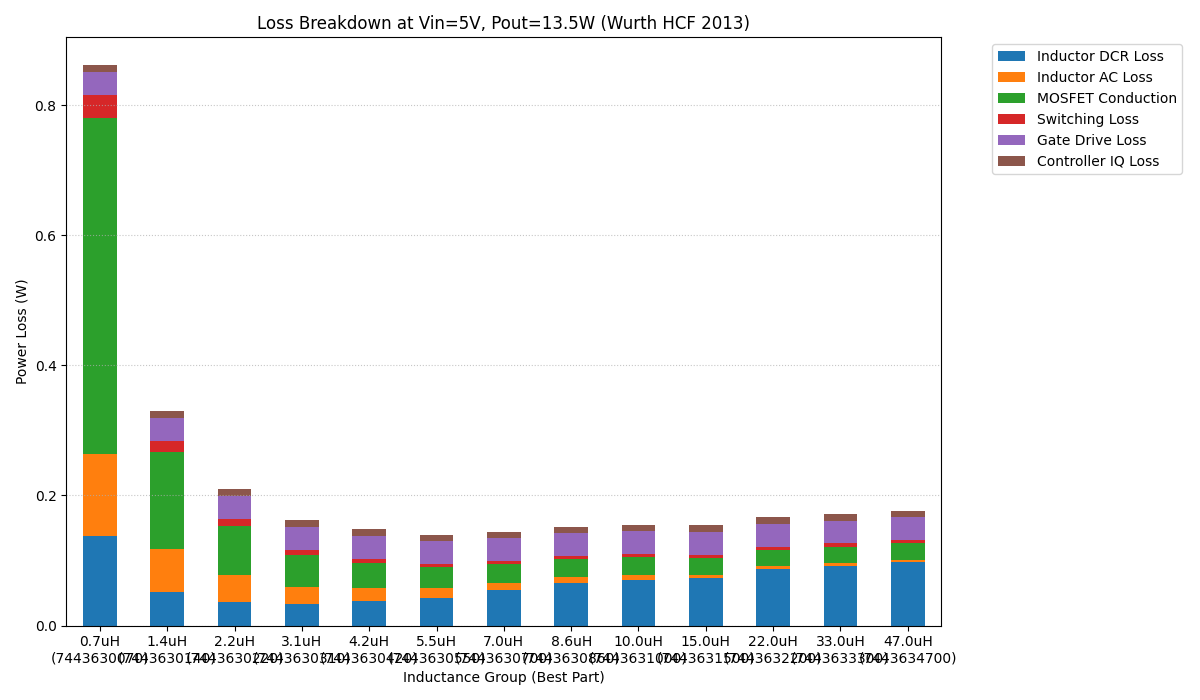
figures/loss_breakdown_with_ac.png
