harrisonhsueh/Buck_Boost_42W/figures/loss_by_family_grouped.png

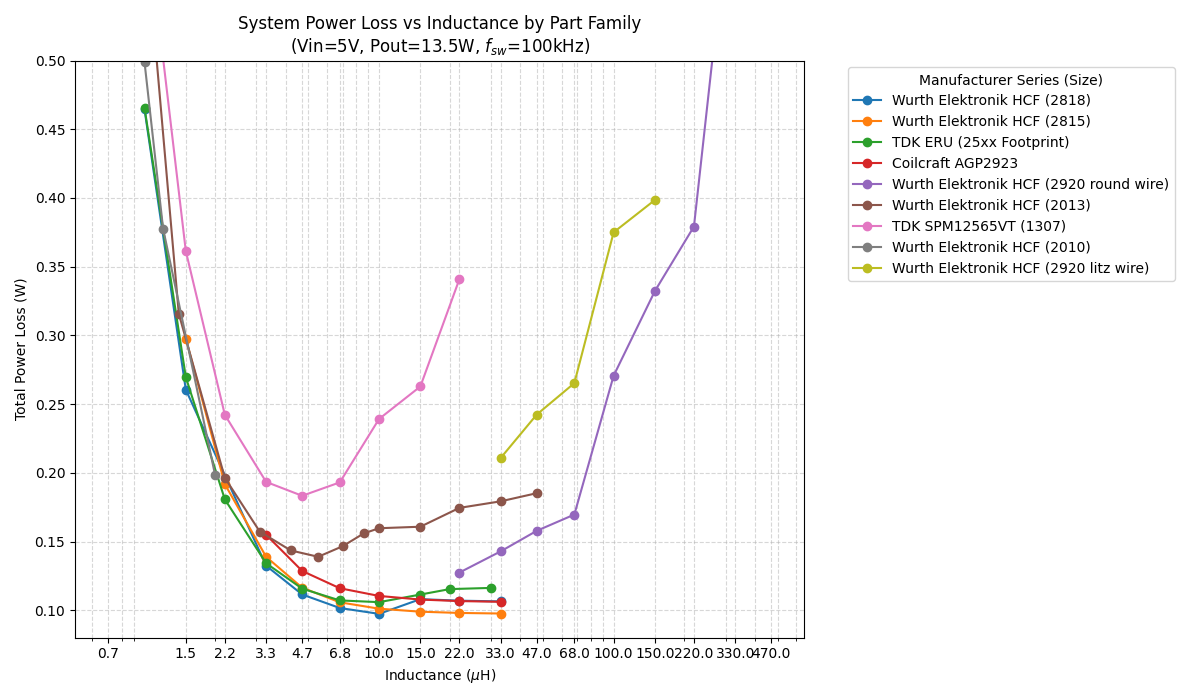
figures/loss_by_family_grouped.png
