harrisonhsueh/Buck_Boost_42W/figures/mosfet_loss_breakdown.png

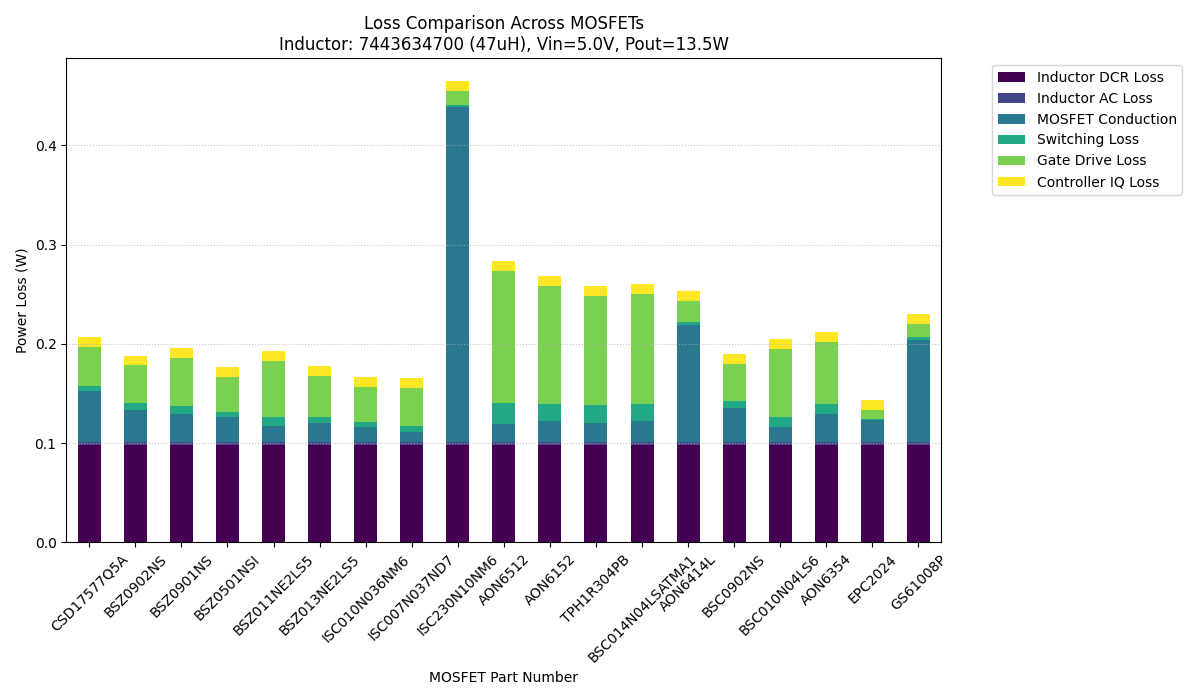
figures/mosfet_loss_breakdown.png
