harrisonhsueh/Buck_Boost_42W/figures/mosfet_loss_breakdown_fixed.png

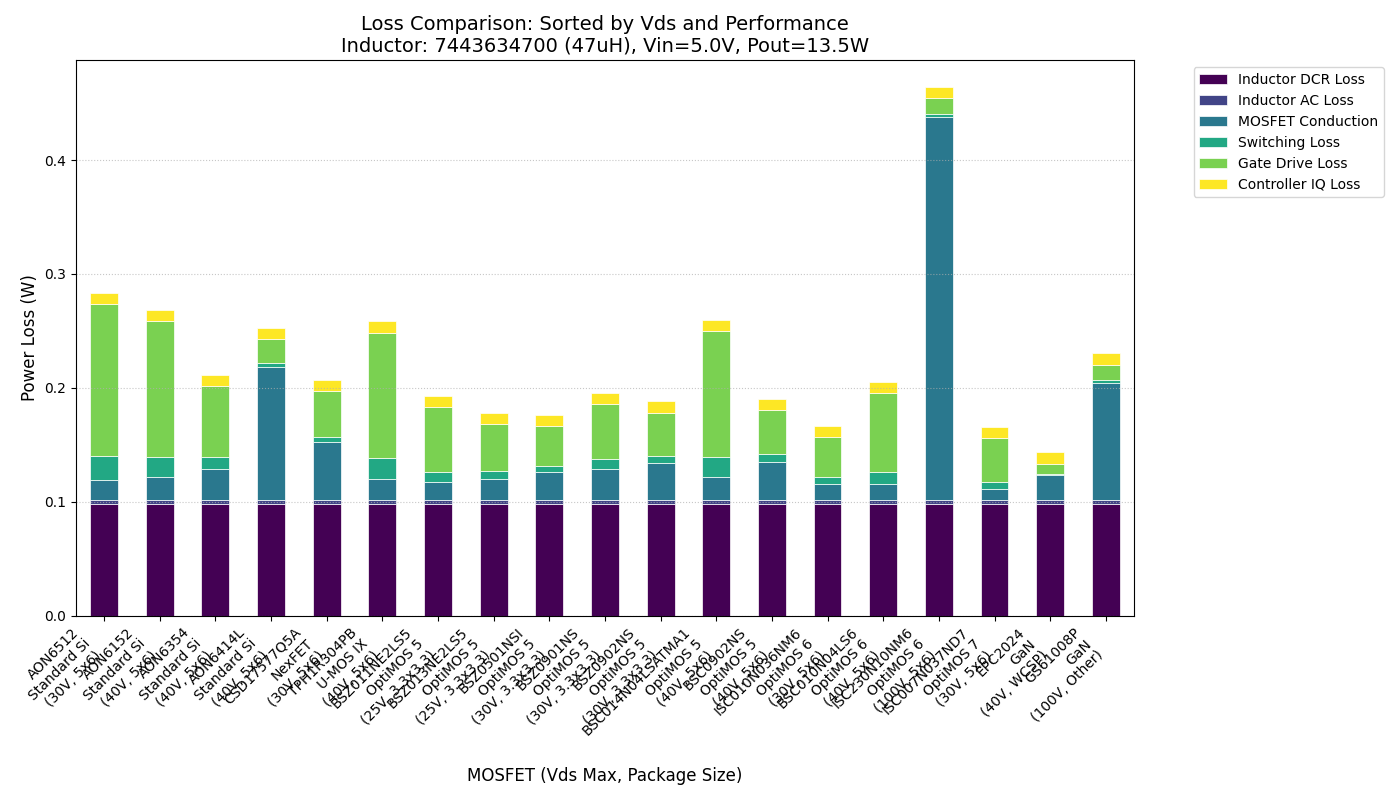
figures/mosfet_loss_breakdown_fixed.png
