harrisonhsueh/Buck_Boost_42W/figures/power_stage_bode_boost.png

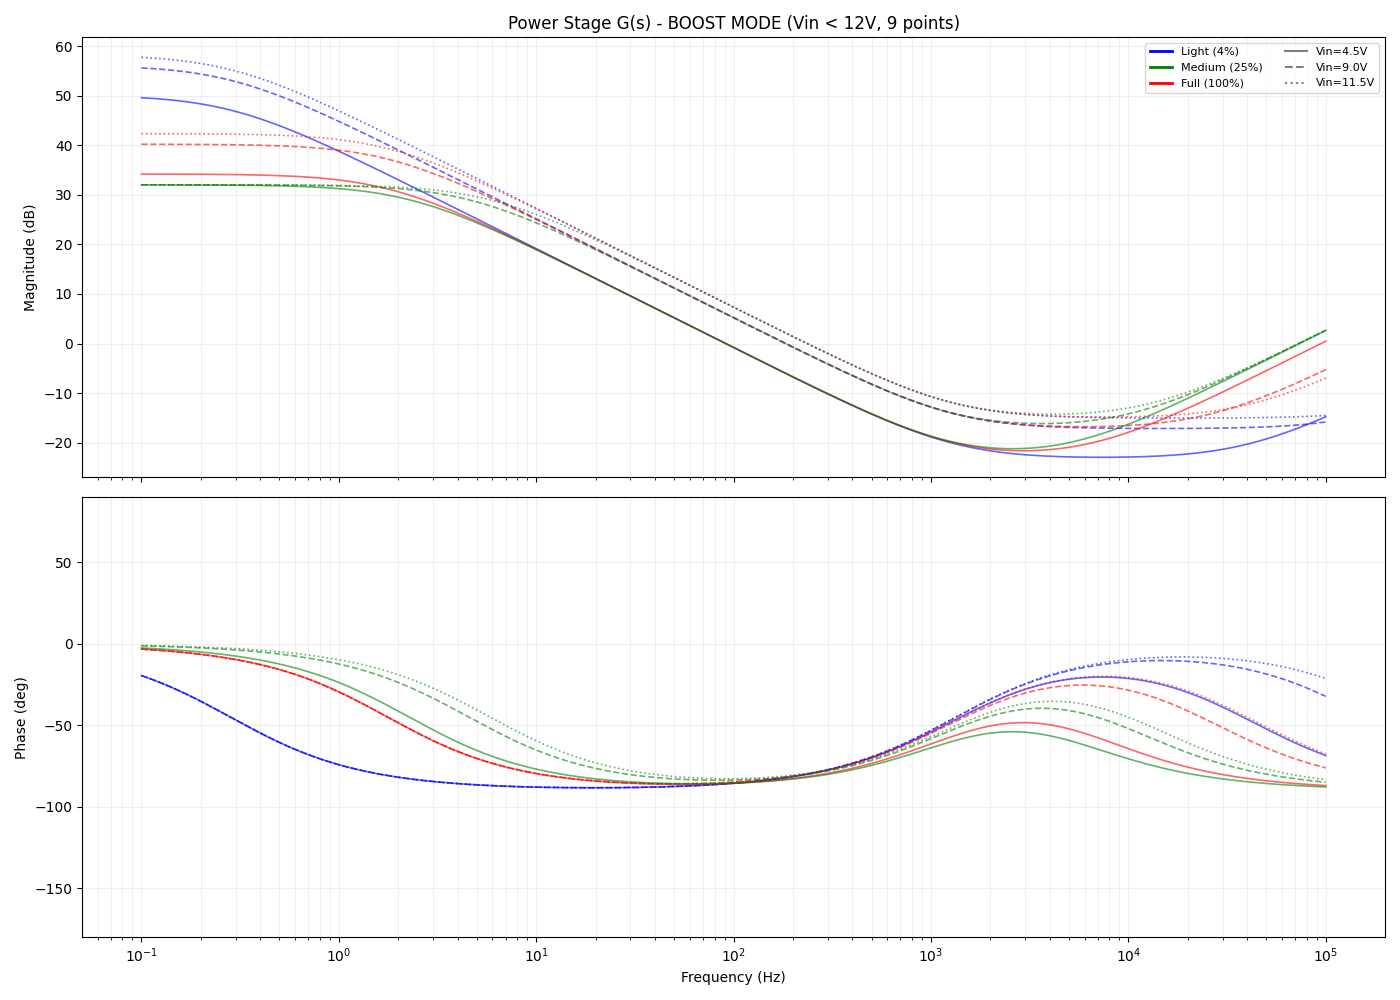
figures/power_stage_bode_boost.png
