harrisonhsueh/Buck_Boost_42W/figures/power_stage_bode_buck.png

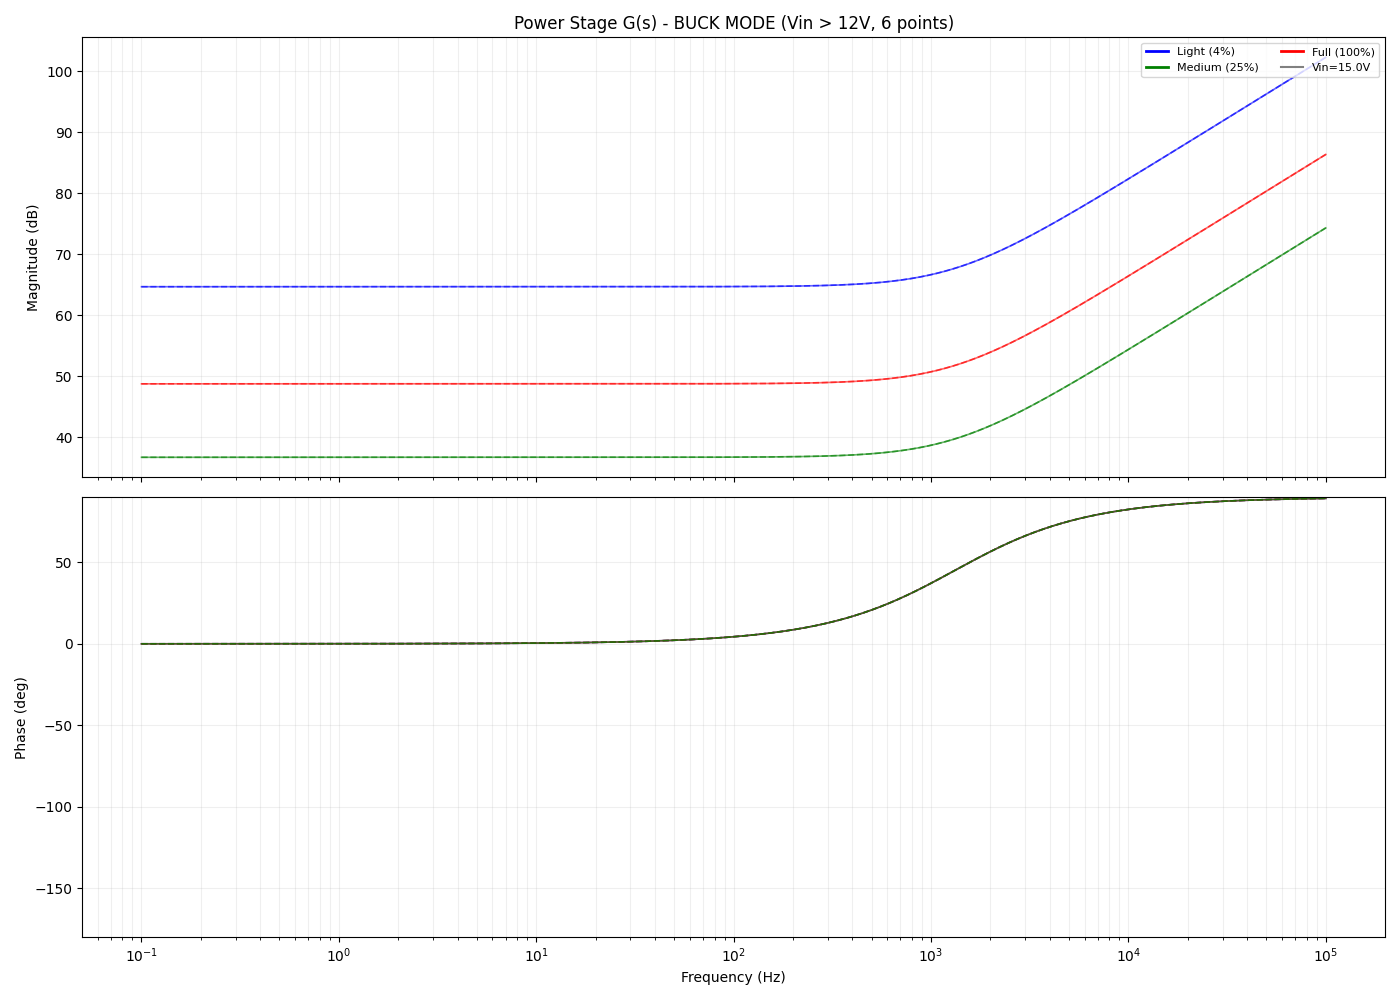
figures/power_stage_bode_buck.png
