harrisonhsueh/Buck_Boost_42W/figures/power_stage_bode_envelope.png

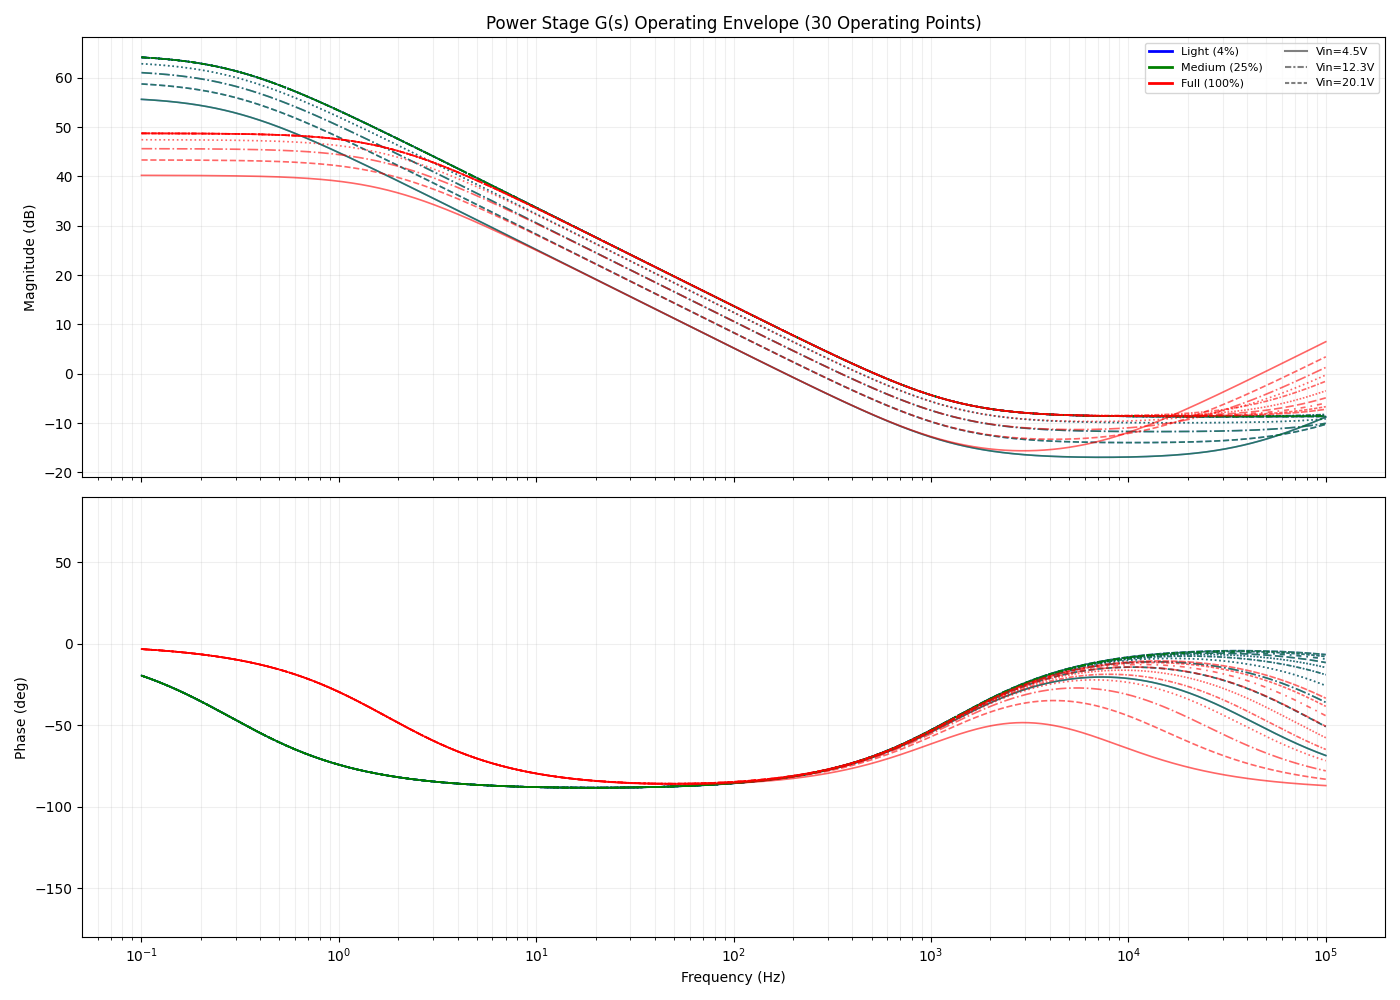
figures/power_stage_bode_envelope.png
