harrisonhsueh/Buck_Boost_42W/figures/total_loss_by_brand_series.png

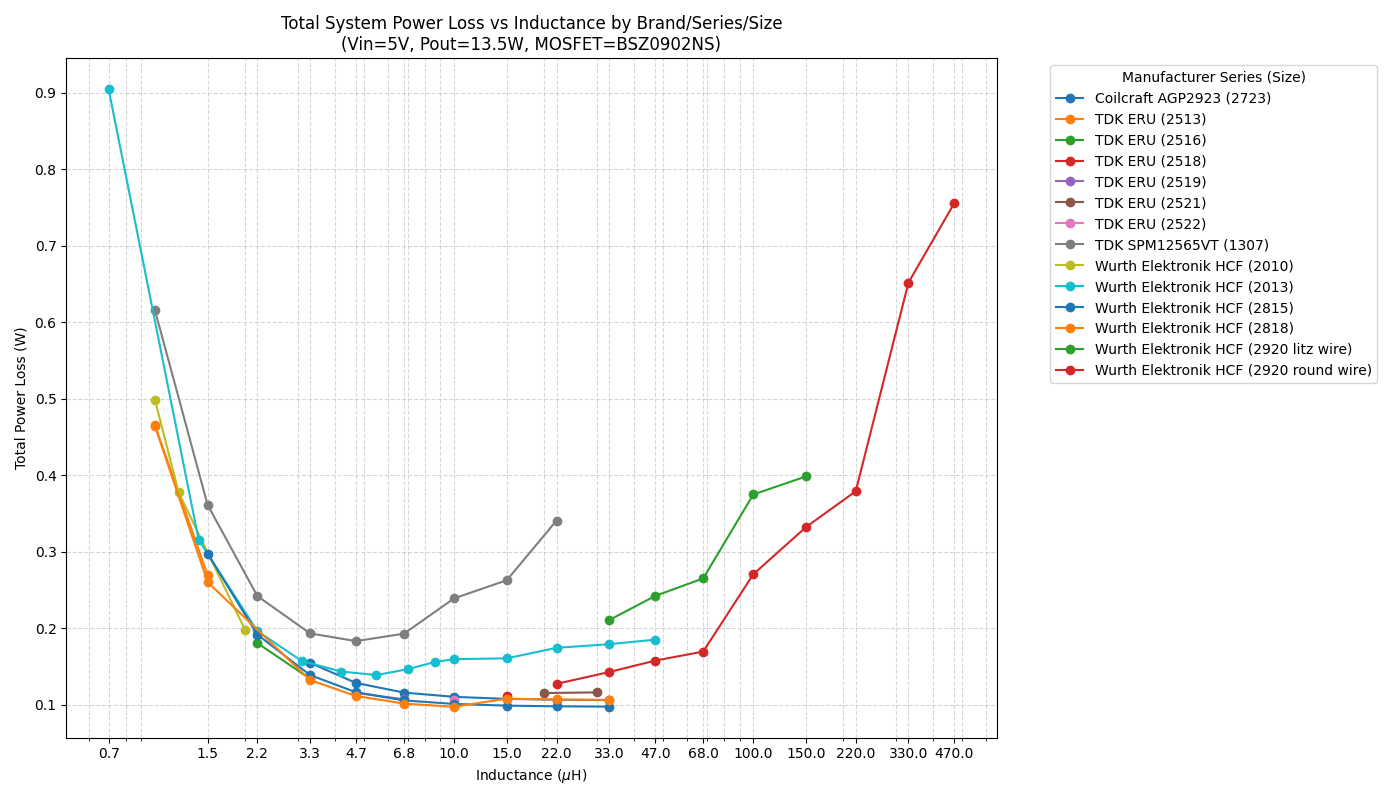
figures/total_loss_by_brand_series.png
