harrisonhsueh/Buck_Boost_42W/figures/total_loss_lines_by_size.png

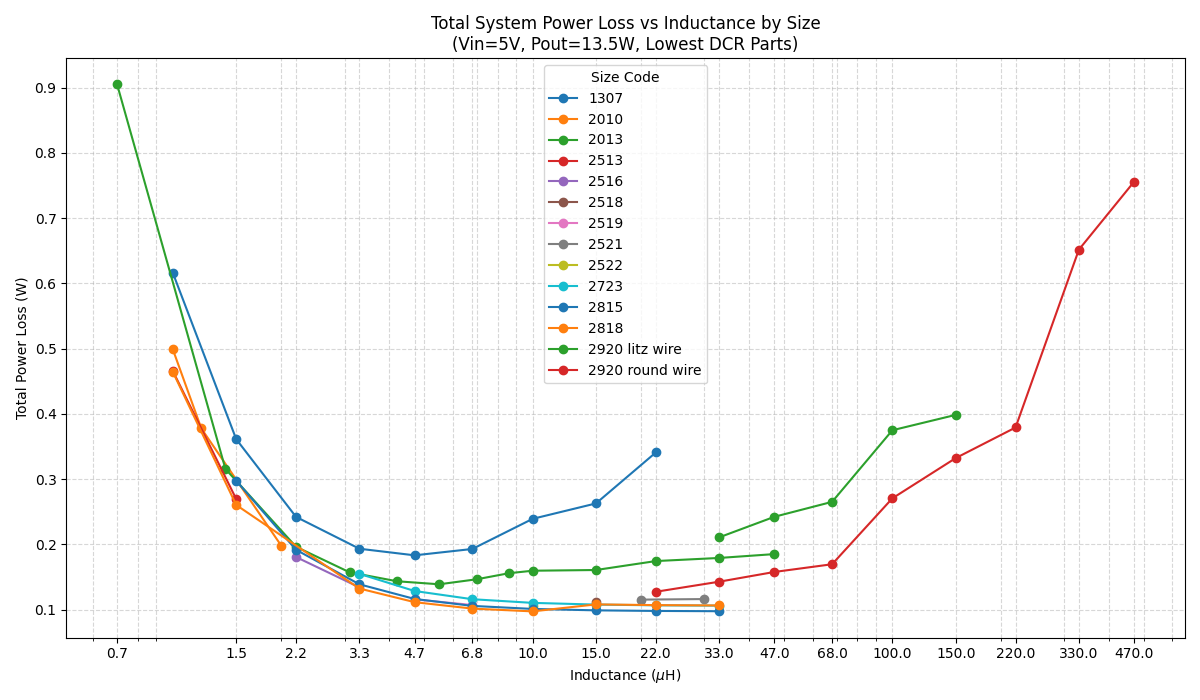
figures/total_loss_lines_by_size.png
