harrisonhsueh/Buck_Boost_42W/notebooks/loss_breakdown_redexpert_vs_rp.png

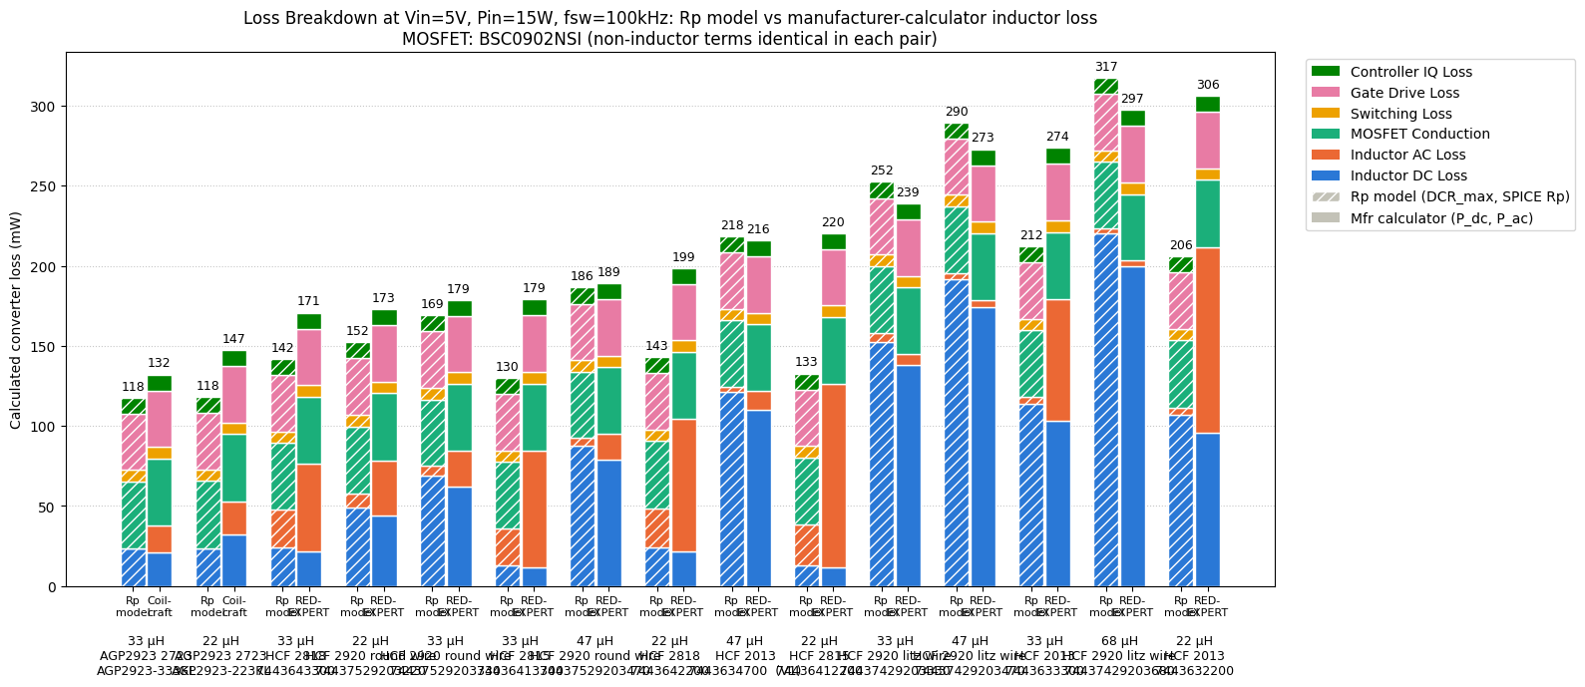
notebooks/loss_breakdown_redexpert_vs_rp.png
