harrisonhsueh/Buck_Boost_42W/notebooks/loss_breakdown_with_ac.png

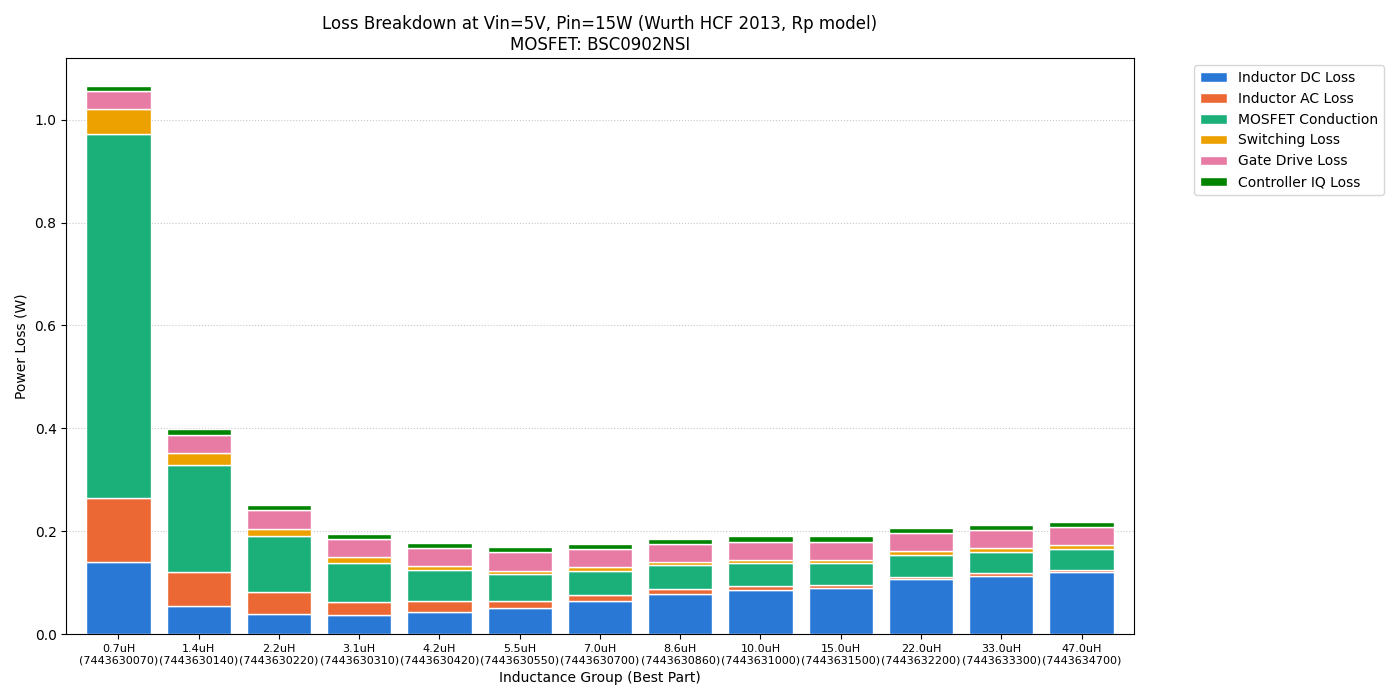
notebooks/loss_breakdown_with_ac.png
