harrisonhsueh/Buck_Boost_42W/notebooks/loss_by_family_consistent.png

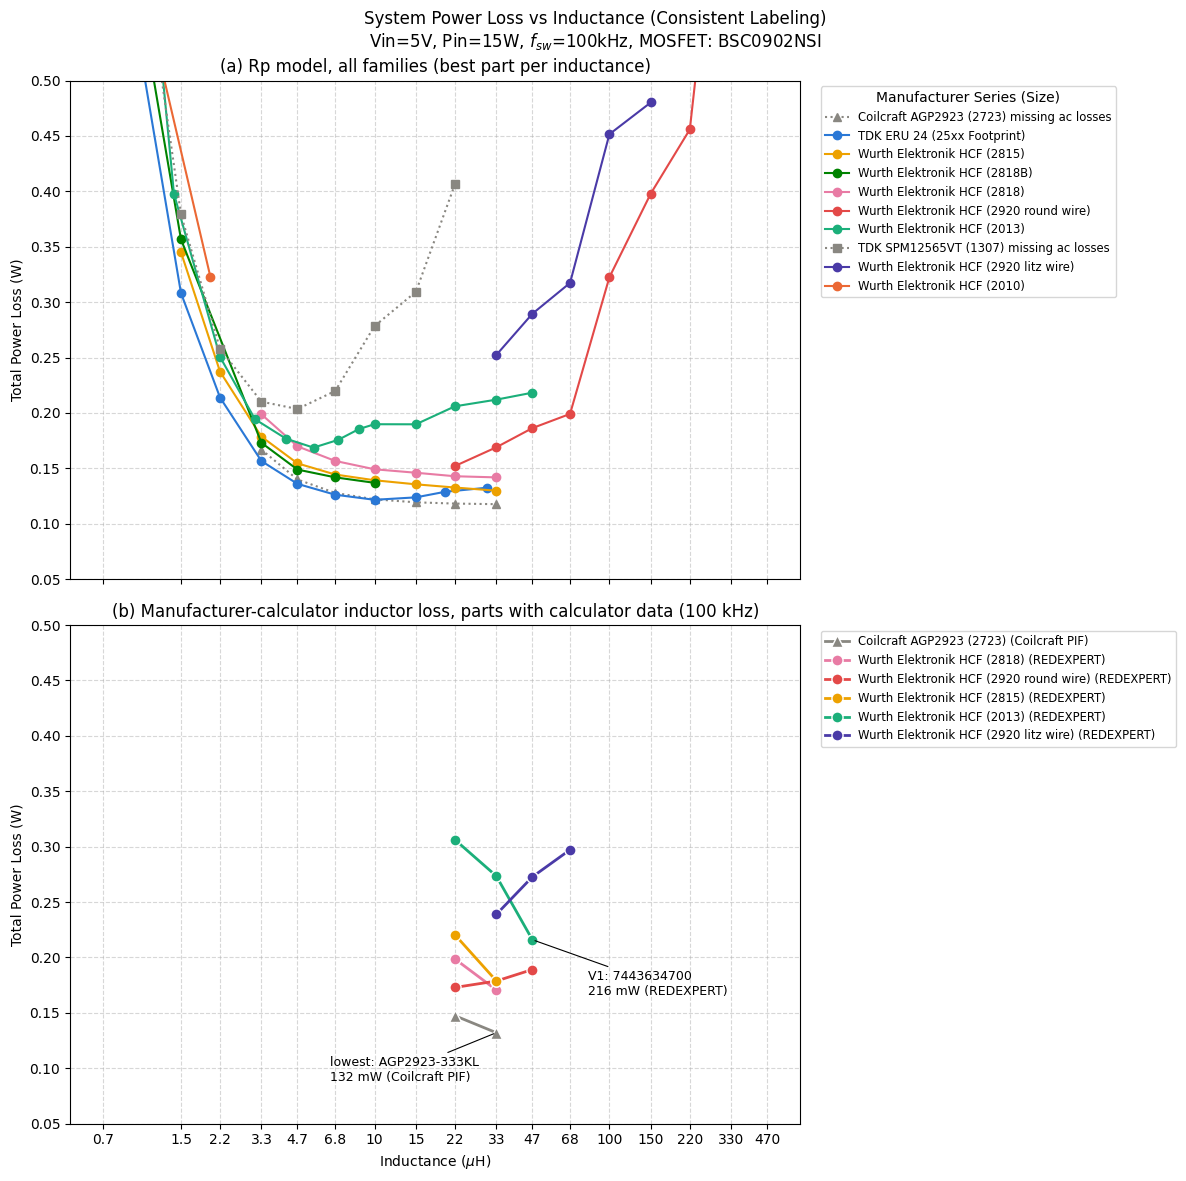
notebooks/loss_by_family_consistent.png
