harrisonhsueh/Buck_Boost_42W/measurements/Scope_P14Pro_Startup_Current_1r57_shunt.csv

ProID | Info | time | Value
GenTime | 2009-08-31 20:14:41 | 0.0 | -0.024
Record Length | 100000 Points | 2.8E-5 | -0.024
Sample Interval | 2.7999999999999996E-5 s | 5.6E-5 | -0.024
Trigger Time | 2.18 s | 8.4E-5 | -0.024
Source | CH1 | 1.12E-4 | -0.024
Vertical Units | (V)/grid | 1.4E-4 | -0.024
Vertical Scale | 0.2 | 1.68E-4 | -0.024
Vertical Offset | 61 | 1.9600001E-4 | -0.024
Horizontal Units | s/grid | 2.24E-4 | -0.024
Horizontal Scale | 0.2 | 2.52E-4 | -0.024
Probe Atten | 10.0 | 2.8E-4 | 0.008
 |  | 3.0800002E-4 | -0.024
 |  | 3.36E-4 | -0.024
 |  | 3.64E-4 | -0.024
 |  | 3.9200002E-4 | -0.040000003
 |  | 4.2E-4 | -0.024
 |  | 4.48E-4 | -0.024
 |  | 4.7600002E-4 | -0.024
 |  | 5.04E-4 | -0.024
 |  | 5.3200003E-4 | -0.024
 |  | 5.6E-4 | -0.024
 |  | 5.88E-4 | -0.024
 |  | 6.1600003E-4 | -0.024
 |  | 6.44E-4 | -0.016
 |  | 6.72E-4 | -0.016
 |  | 7.0000003E-4 | -0.016
 |  | 7.28E-4 | -0.024
 |  | 7.56E-4 | -0.032
 |  | 7.8400003E-4 | -0.024
 |  | 8.12E-4 | -0.024
 |  | 8.4E-4 | -0.024
 |  | 8.6800003E-4 | -0.024
 |  | 8.96E-4 | -0.024
 |  | 9.24E-4 | -0.024
 |  | 9.5200003E-4 | -0.024
 |  | 9.8E-4 | -0.024
 |  | 0.001008 | -0.024
 |  | 0.001036 | -0.024
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
