harrisonhsueh/Buck_Boost_42W/measurements/Scope_P14Pro_Startup_Current_1r57_shunt_full.csv

ProID | Info | time | Value
GenTime | 2009-08-31 20:04:41 | 0.0 | -0.024
Record Length | 100000 Points | 2.8E-4 | -0.024
Sample Interval | 2.8E-4 s | 5.6E-4 | -0.024
Trigger Time | 10.0 s | 8.4E-4 | -0.024
Source | CH1 | 0.00112 | -0.024
Vertical Units | (V)/grid | 0.0014000001 | -0.024
Vertical Scale | 0.2 | 0.00168 | -0.024
Vertical Offset | 61 | 0.00196 | -0.024
Horizontal Units | s/grid | 0.00224 | -0.024
Horizontal Scale | 2.0 | 0.00252 | -0.024
Probe Atten | 10.0 | 0.0028000001 | -0.024
 |  | 0.0030800002 | -0.024
 |  | 0.00336 | -0.024
 |  | 0.00364 | -0.024
 |  | 0.00392 | -0.024
 |  | 0.0042000003 | -0.024
 |  | 0.00448 | -0.024
 |  | 0.00476 | 0.068
 |  | 0.00504 | -0.024
 |  | 0.00532 | -0.024
 |  | 0.0056000003 | -0.024
 |  | 0.00588 | -0.024
 |  | 0.0061600003 | -0.024
 |  | 0.00644 | -0.016
 |  | 0.00672 | -0.024
 |  | 0.007 | -0.024
 |  | 0.00728 | -0.024
 |  | 0.0075600003 | -0.024
 |  | 0.00784 | -0.040000003
 |  | 0.00812 | -0.024
 |  | 0.008400001 | -0.024
 |  | 0.00868 | -0.024
 |  | 0.00896 | -0.024
 |  | 0.0092400005 | -0.032
 |  | 0.00952 | -0.016
 |  | 0.0098 | -0.016
 |  | 0.01008 | -0.016
 |  | 0.010360001 | -0.016
 |  | 0.01064 | -0.024
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
