harrisonhsueh/Buck_Boost_42W/measurements/Scope_P14Pro_Startup_Current_1r57_shunt_trunc.csv

ProID | Info | time | Value
GenTime | 2009-09-01 06:18:40 | 0.0 | -0.024
Record Length | 3500 Points | 8.0E-6 | -0.016
Sample Interval | 8.0E-6 s | 1.6E-5 | 0.0
Trigger Time | 1.022 s | 2.4E-5 | -0.016
Source | CH1 | 3.2E-5 | -0.016
Vertical Units | (V)/grid | 4.0E-5 | -0.024
Vertical Scale | 0.2 | 4.8E-5 | -0.016
Vertical Offset | 185 | 5.6E-5 | -0.016
Horizontal Units | s/grid | 6.4E-5 | -0.024
Horizontal Scale | 0.002 | 7.2E-5 | -0.016
Probe Atten | 10.0 | 8.0E-5 | -0.024
 |  | 8.8E-5 | -0.032
 |  | 9.6E-5 | -0.024
 |  | 1.04E-4 | -0.024
 |  | 1.12E-4 | -0.024
 |  | 1.2E-4 | -0.024
 |  | 1.28E-4 | -0.024
 |  | 1.36E-4 | -0.024
 |  | 1.44E-4 | -0.024
 |  | 1.52E-4 | -0.024
 |  | 1.6E-4 | -0.016
 |  | 1.68E-4 | -0.024
 |  | 1.76E-4 | -0.024
 |  | 1.84E-4 | -0.024
 |  | 1.92E-4 | -0.024
 |  | 2.0E-4 | -0.024
 |  | 2.08E-4 | -0.024
 |  | 2.16E-4 | -0.024
 |  | 2.24E-4 | -0.024
 |  | 2.32E-4 | -0.024
 |  | 2.4E-4 | -0.024
 |  | 2.48E-4 | -0.024
 |  | 2.56E-4 | -0.016
 |  | 2.64E-4 | -0.024
 |  | 2.72E-4 | -0.016
 |  | 2.8E-4 | -0.024
 |  | 2.88E-4 | -0.024
 |  | 2.96E-4 | -0.016
 |  | 3.04E-4 | -0.016
 |  | 3.12E-4 | -0.024
 |  | 3.2E-4 | -0.032
 |  | 3.28E-4 | -0.016
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
