harrisonhsueh/Buck_Boost_42W/figures/11_loss_breakdown_vs_measured.png

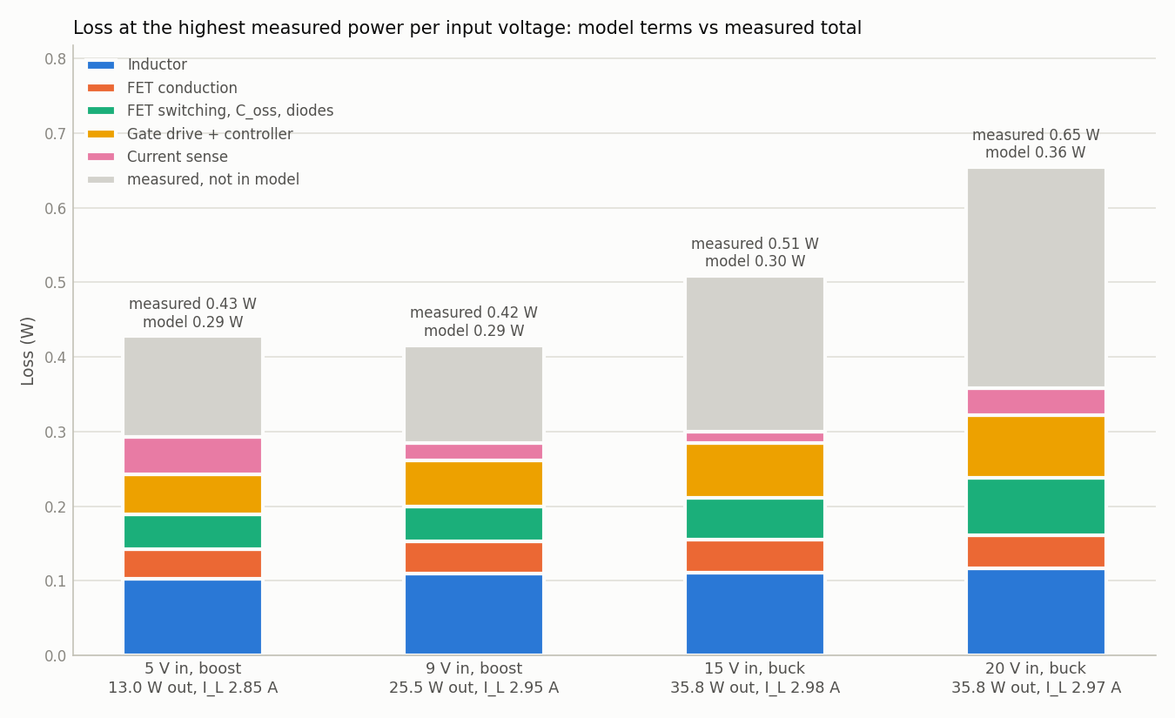
figures/11_loss_breakdown_vs_measured.png
