harrisonhsueh/Buck_Boost_42W/measurements/efficiency/2026-09-15_114836_fans_5V_cal.png

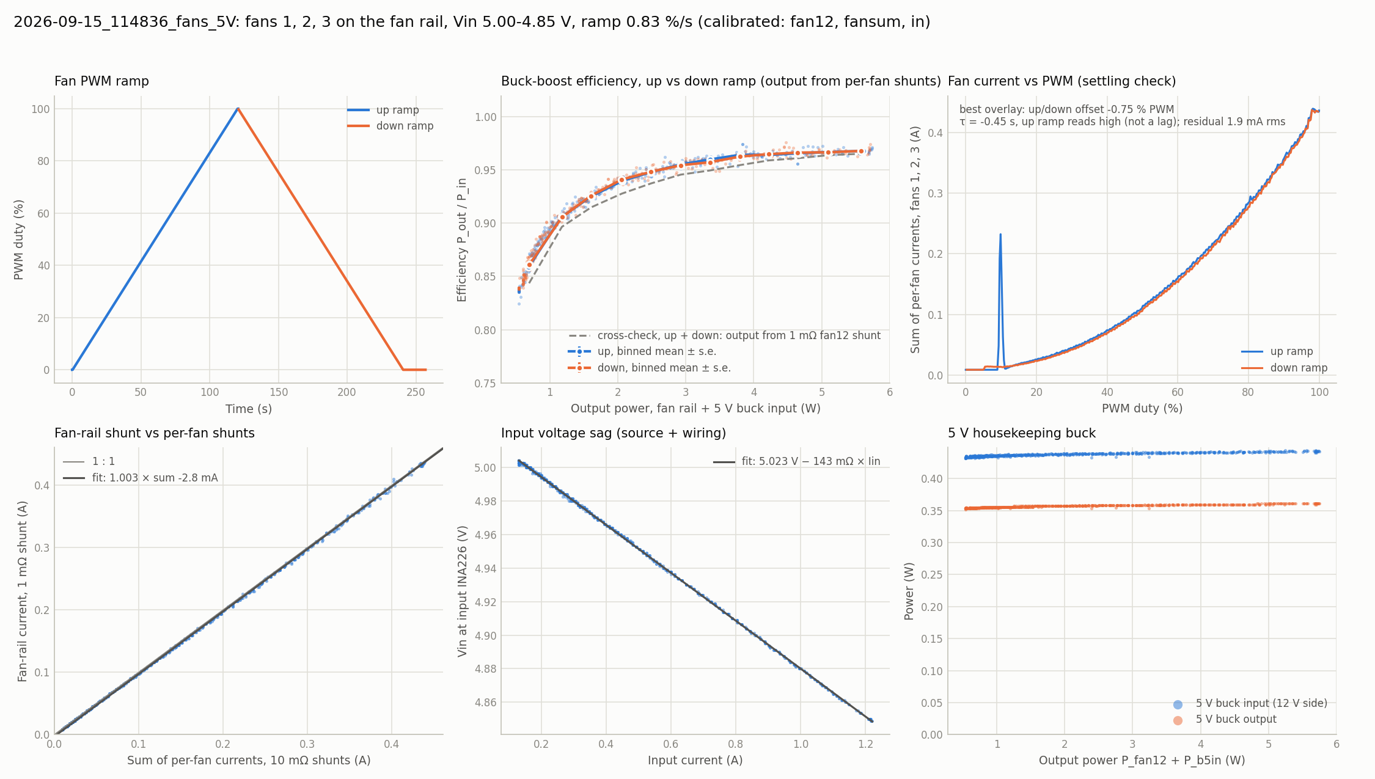
measurements/efficiency/2026-09-15_114836_fans_5V_cal.png
