harrisonhsueh/Buck_Boost_42W/measurements/efficiency/2026-09-15_115614_fans_9V.png

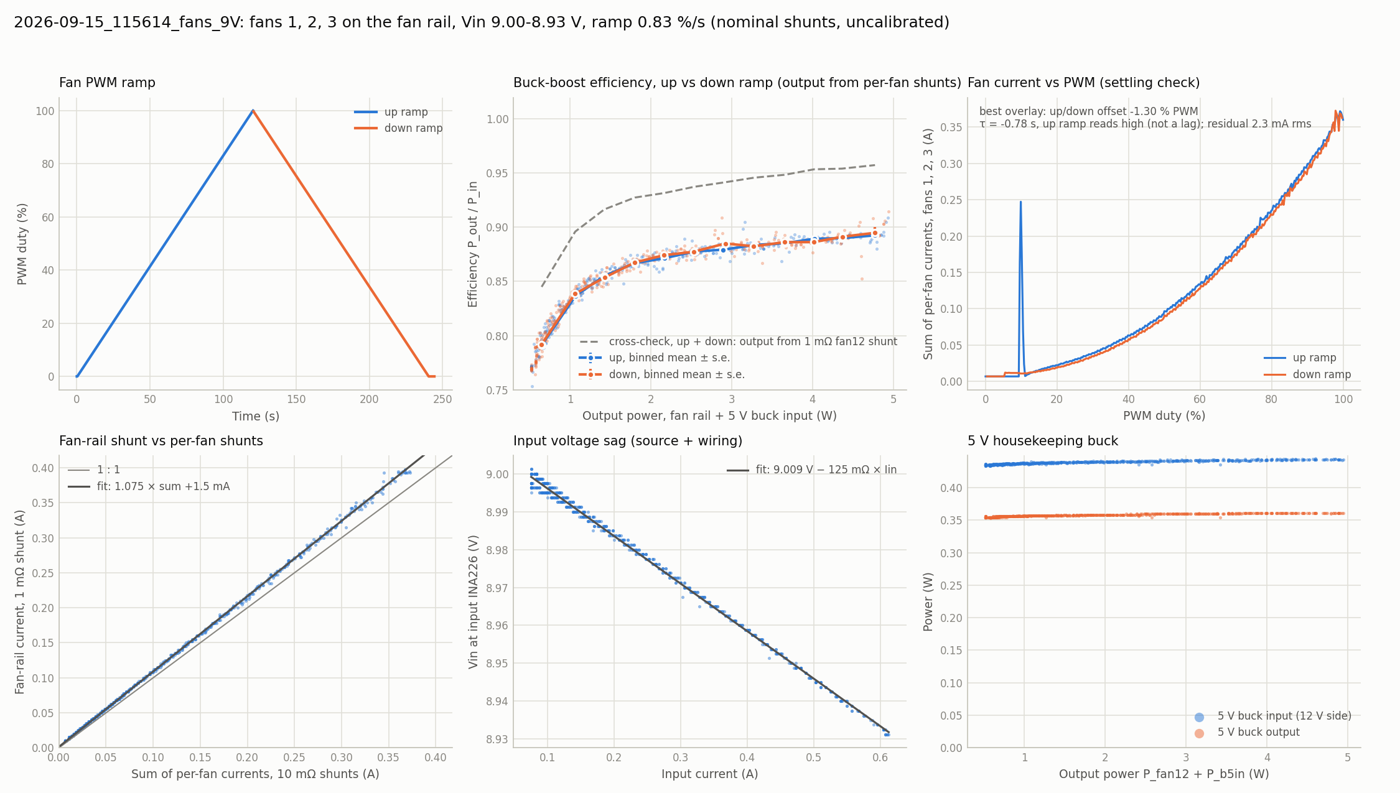
measurements/efficiency/2026-09-15_115614_fans_9V.png
