harrisonhsueh/Buck_Boost_42W/measurements/efficiency/2026-09-15_141025_fans_15V.png

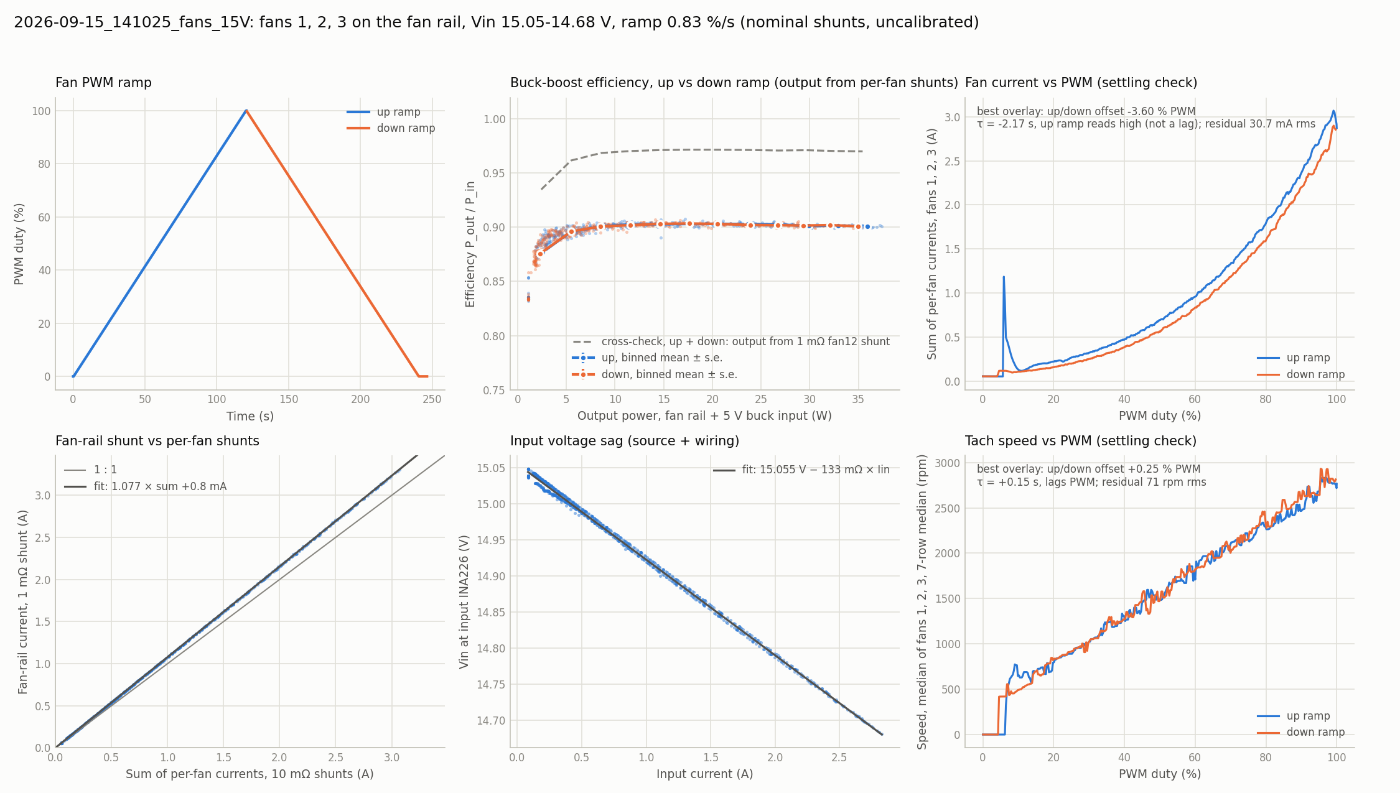
measurements/efficiency/2026-09-15_141025_fans_15V.png
