harrisonhsueh/Buck_Boost_42W/measurements/efficiency/2026-09-15_141459_fans_20V_cal.png

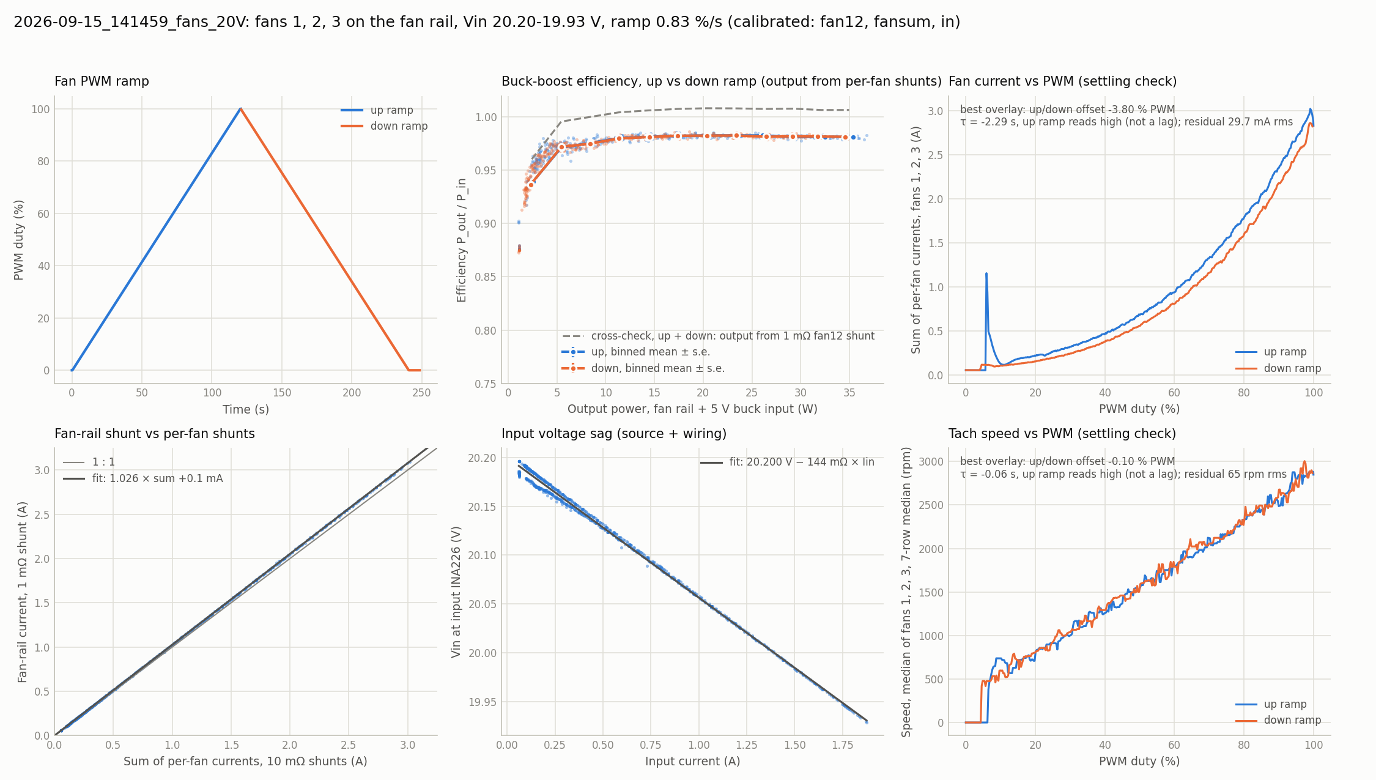
measurements/efficiency/2026-09-15_141459_fans_20V_cal.png
