harrisonhsueh/Buck_Boost_42W/measurements/efficiency/2026-09-15_efficiency_summary.png

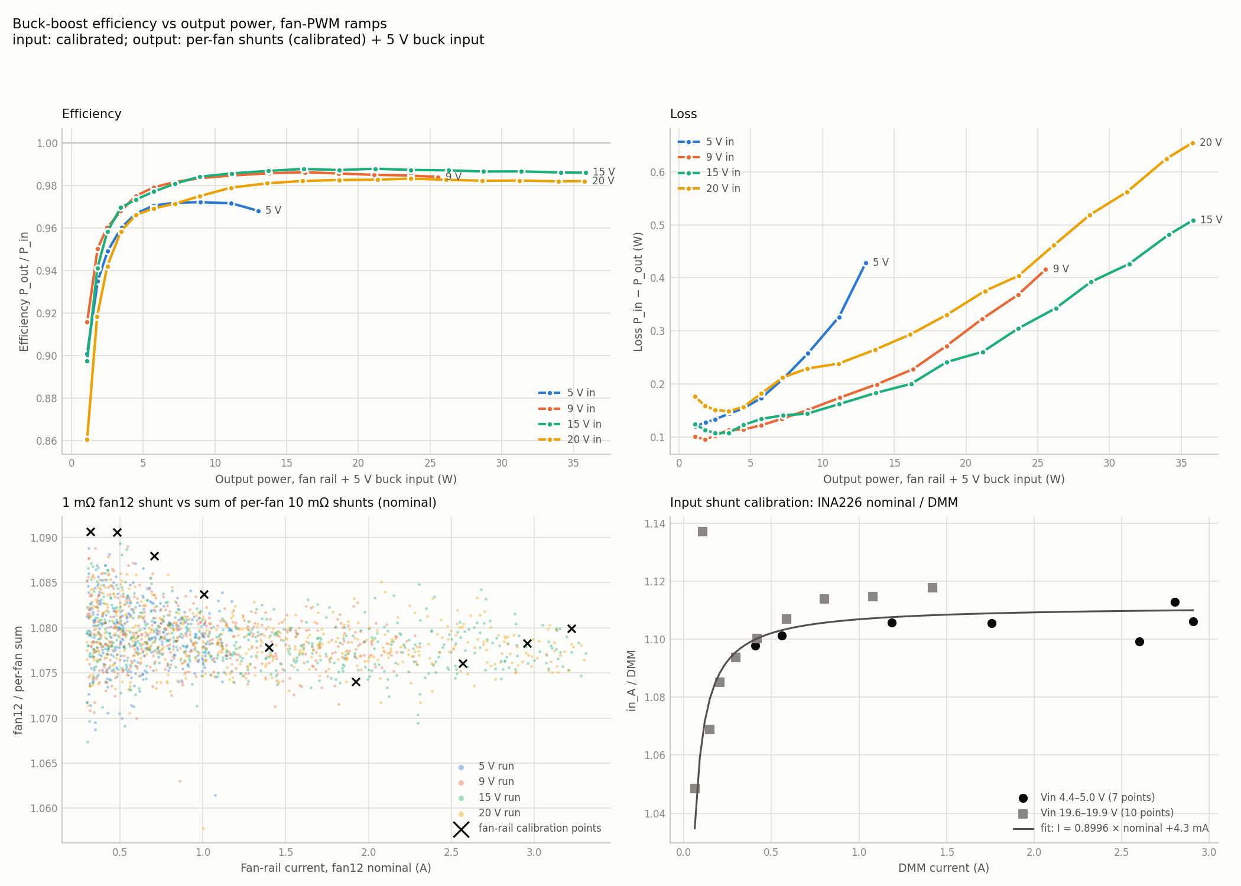
measurements/efficiency/2026-09-15_efficiency_summary.png
