harrisonhsueh/Buck_Boost_42W/measurements/prebias startup/1st emails/annotated/1) first pre-bias turn on.png

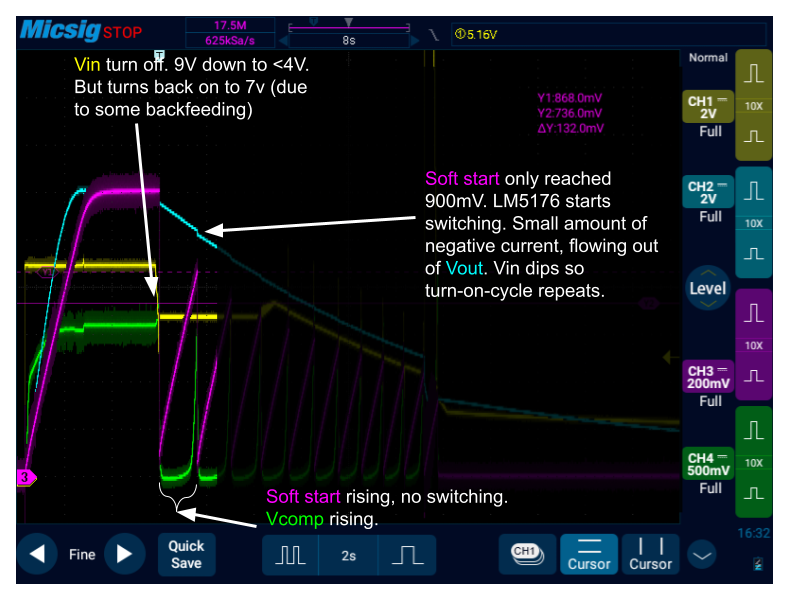
measurements/prebias startup/1st emails/annotated/1) first pre-bias turn on.png
