harrisonhsueh/Buck_Boost_42W/measurements/prebias startup/1st emails/annotated/2) later pre-bias turn on with large backfeed.png

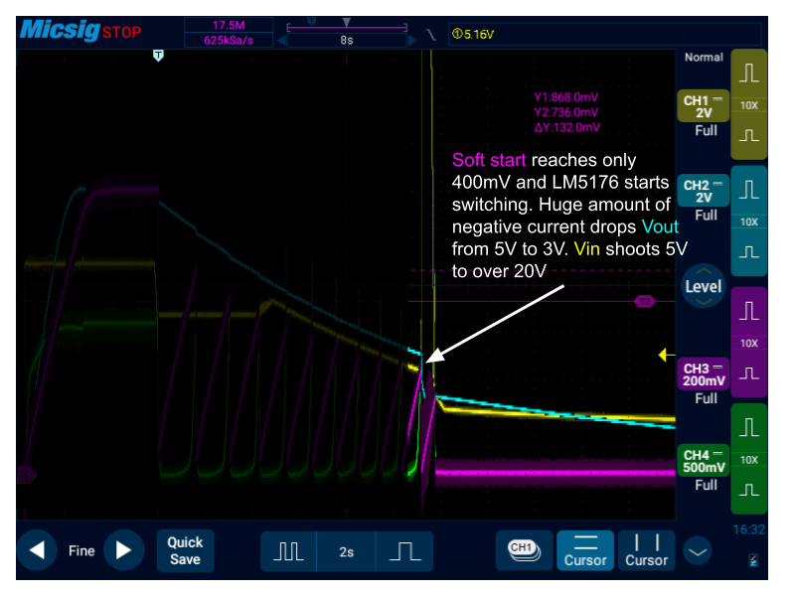
measurements/prebias startup/1st emails/annotated/2) later pre-bias turn on with large backfeed.png
