harrisonhsueh/Buck_Boost_42W/measurements/prebias startup/1st emails/Screenshot_2026-05-01-16-10-11.png

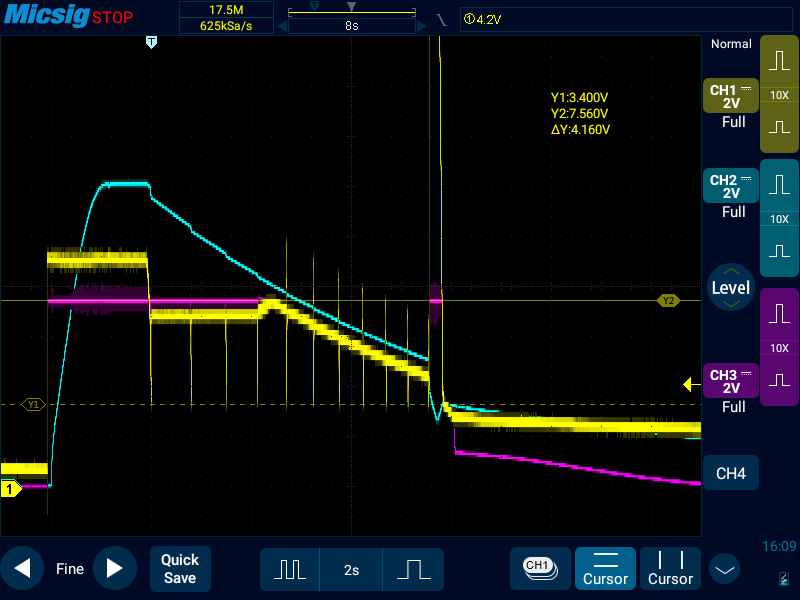
measurements/prebias startup/1st emails/Screenshot_2026-05-01-16-10-11.png
