harrisonhsueh/Buck_Boost_42W/measurements/prebias startup/2026-05-05/annotated/2025-05-05 1) zoomed_out vin vout vsoftstart vswbuck.png

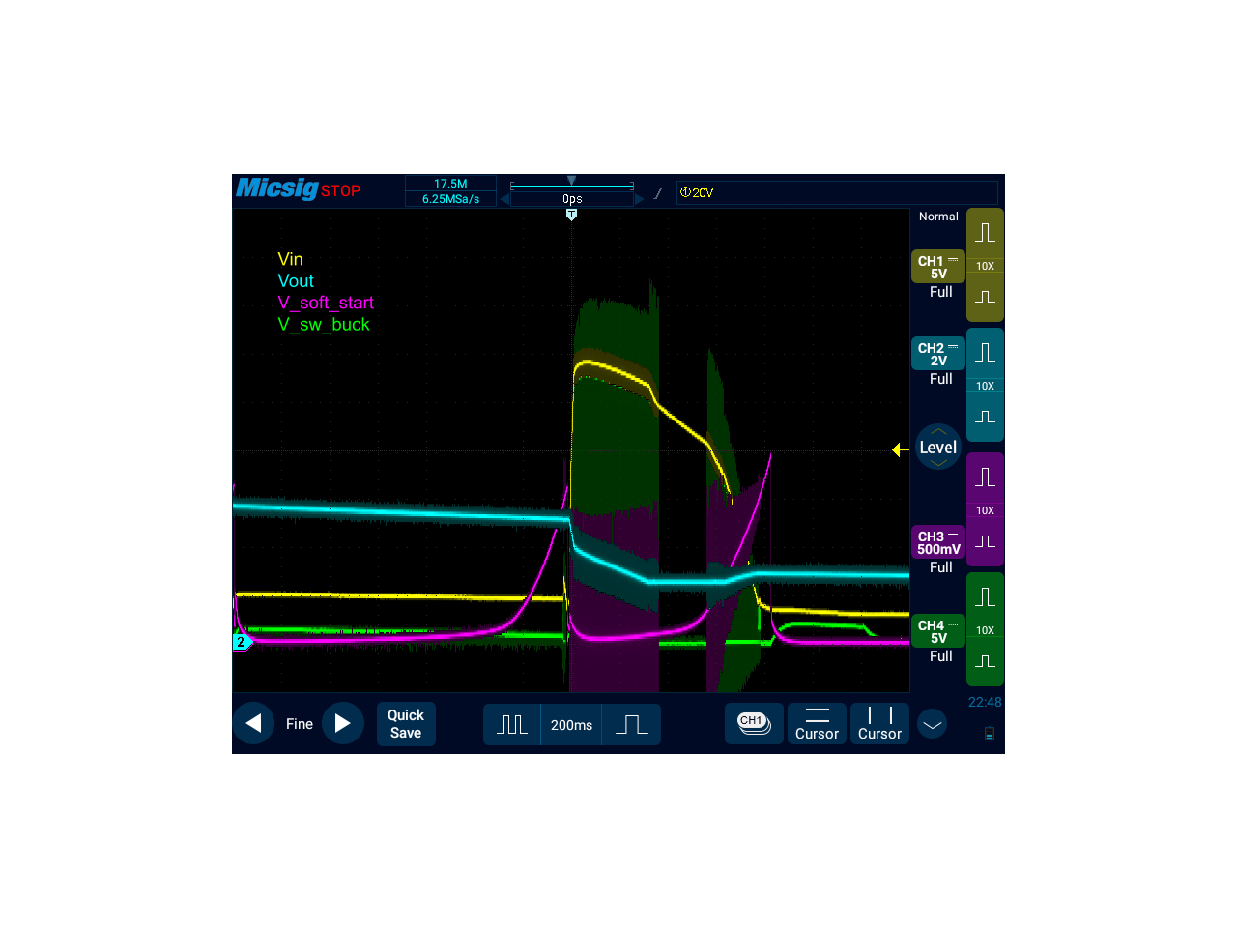
measurements/prebias startup/2026-05-05/annotated/2025-05-05 1) zoomed_out vin vout vsoftstart vswbuck.png
