harrisonhsueh/Buck_Boost_42W/measurements/prebias startup/2026-05-05/annotated/2025-05-05 3) zoomed_in vin vout vsoftstart vswbuck.png

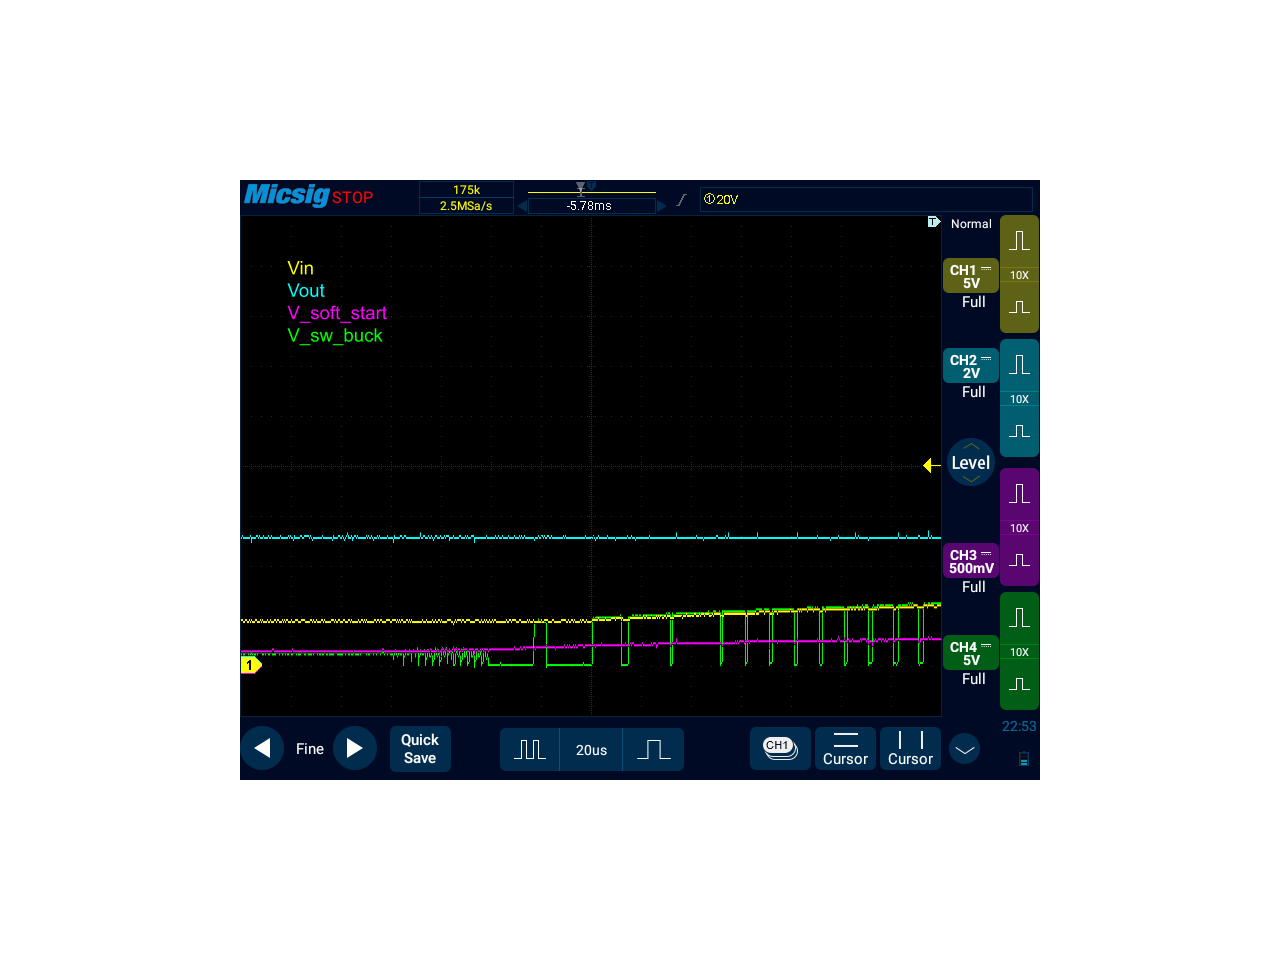
measurements/prebias startup/2026-05-05/annotated/2025-05-05 3) zoomed_in vin vout vsoftstart vswbuck.png
