harrisonhsueh/Buck_Boost_42W/measurements/prebias startup/2026-05-05/annotated/2025-05-05 5b) zoomed_out stacked vin vout vghbuck vswbuck.png

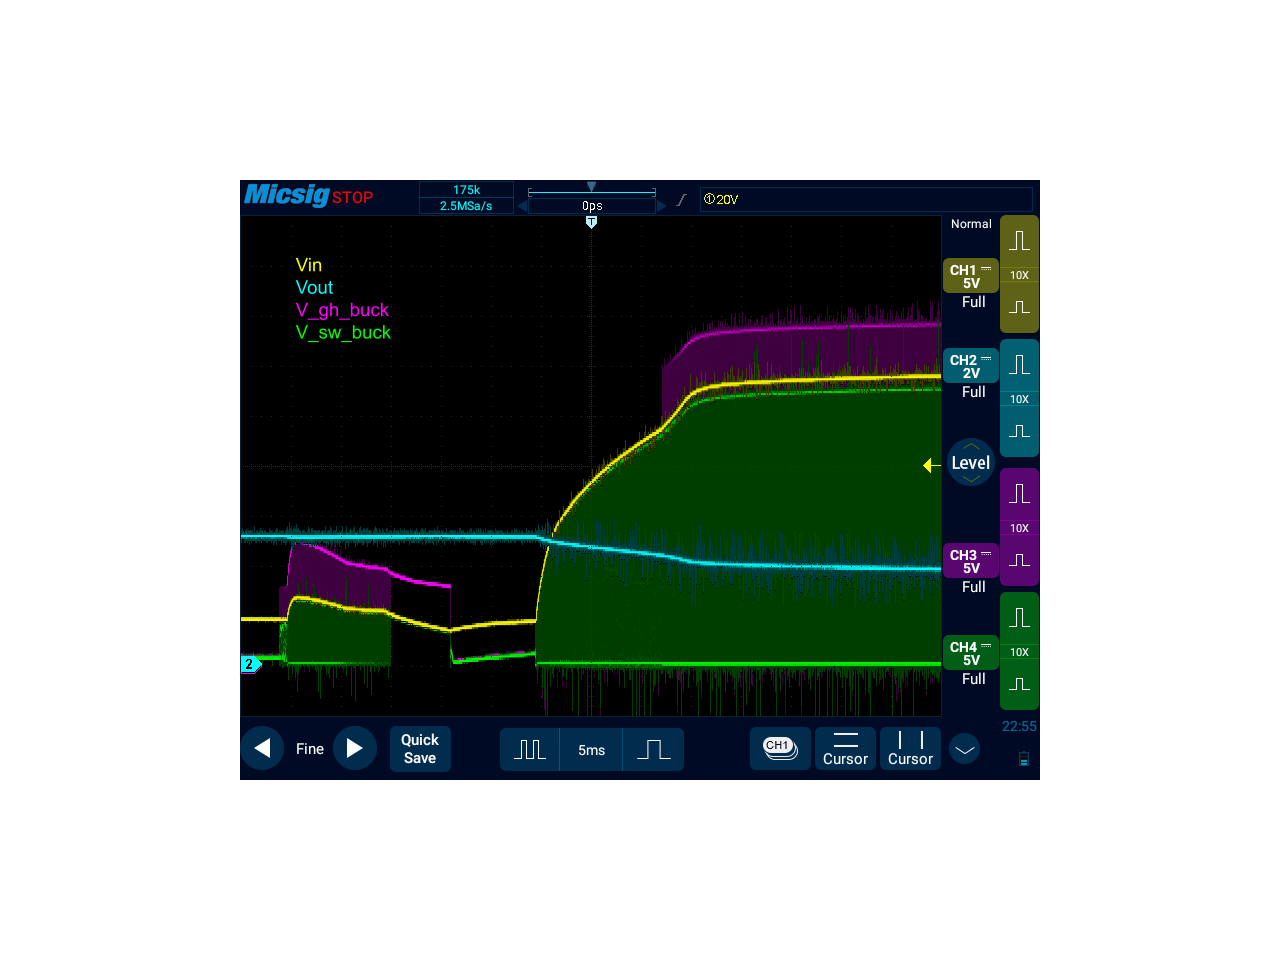
measurements/prebias startup/2026-05-05/annotated/2025-05-05 5b) zoomed_out stacked vin vout vghbuck vswbuck.png
