harrisonhsueh/Buck_Boost_42W/measurements/prebias startup/2026-05-05/annotated/2025-05-05 6) zoomed_in stacked vin vout vghbuck vswbuck.png

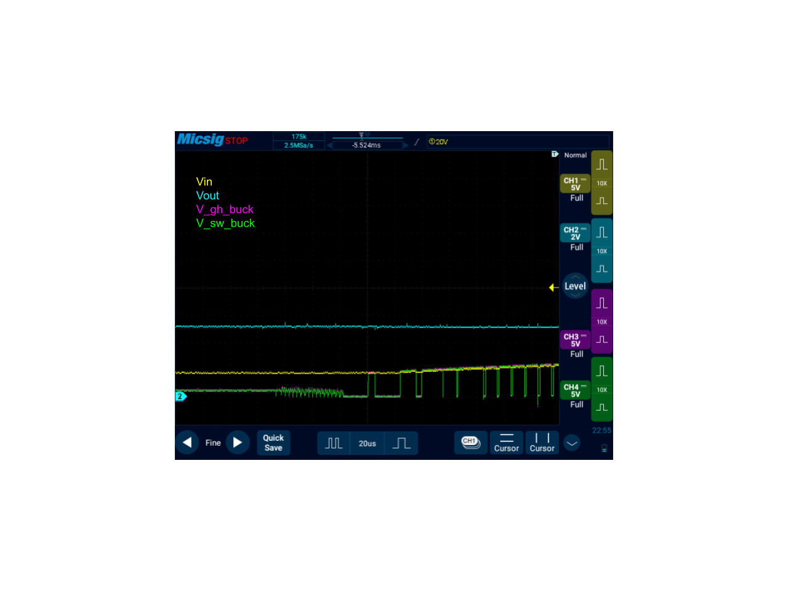
measurements/prebias startup/2026-05-05/annotated/2025-05-05 6) zoomed_in stacked vin vout vghbuck vswbuck.png
