harrisonhsueh/Buck_Boost_42W/measurements/prebias startup/2026-05-05/annotated/2025-05-05 6b) zoomed_in separated vin vout vghbuck vswbuck.png

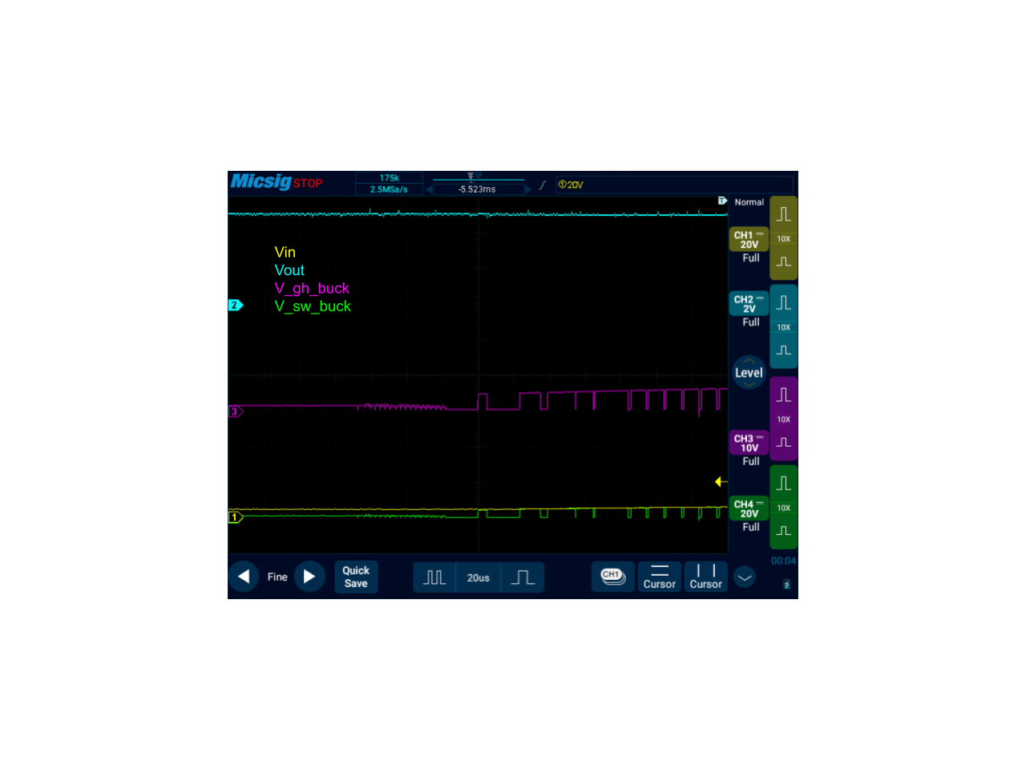
measurements/prebias startup/2026-05-05/annotated/2025-05-05 6b) zoomed_in separated vin vout vghbuck vswbuck.png
