harrisonhsueh/Buck_Boost_42W/measurements/prebias startup/2026-05-05/Screenshot_2026-05-05-22-53-47.png

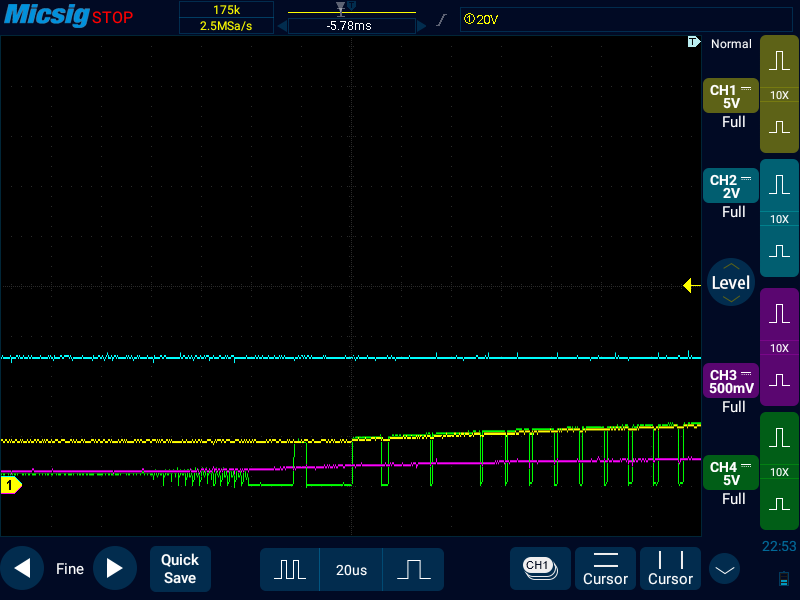
measurements/prebias startup/2026-05-05/Screenshot_2026-05-05-22-53-47.png
