harrisonhsueh/Buck_Boost_42W/measurements/prebias startup/2026-05-05/Screenshot_2026-05-06-00-04-36.png

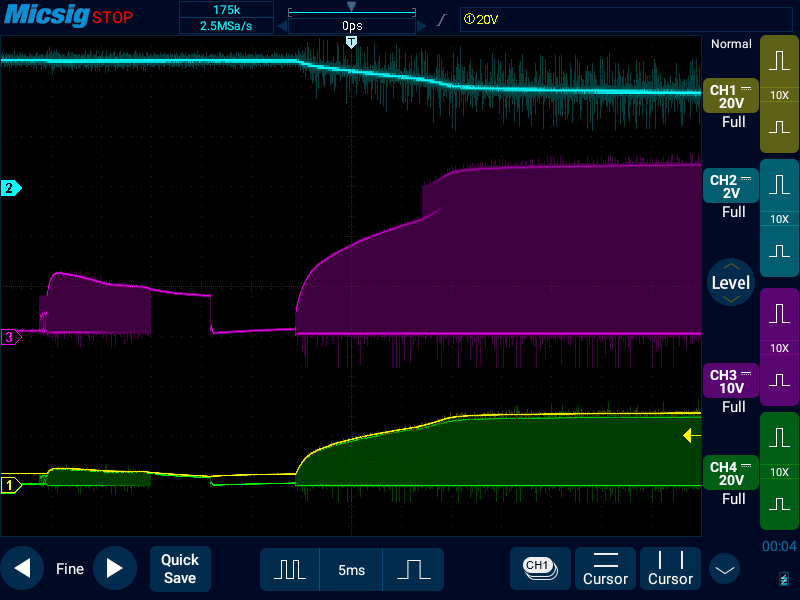
measurements/prebias startup/2026-05-05/Screenshot_2026-05-06-00-04-36.png
