harrisonhsueh/Buck_Boost_42W/measurements/prebias startup/2026-05-07/annotated/2025-05-07 2) vin vout vsoftstart vswbuck 5ms.png

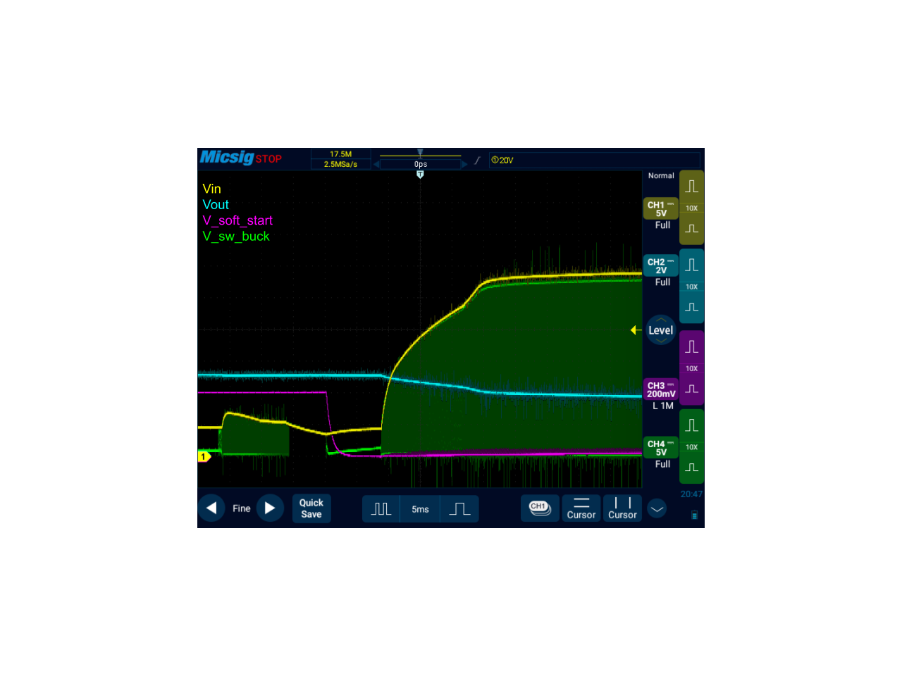
measurements/prebias startup/2026-05-07/annotated/2025-05-07 2) vin vout vsoftstart vswbuck 5ms.png
