harrisonhsueh/Buck_Boost_42W/measurements/prebias startup/2026-05-07/annotated/2025-05-07 3) vin vout vsoftstart vswbuck 50us.png

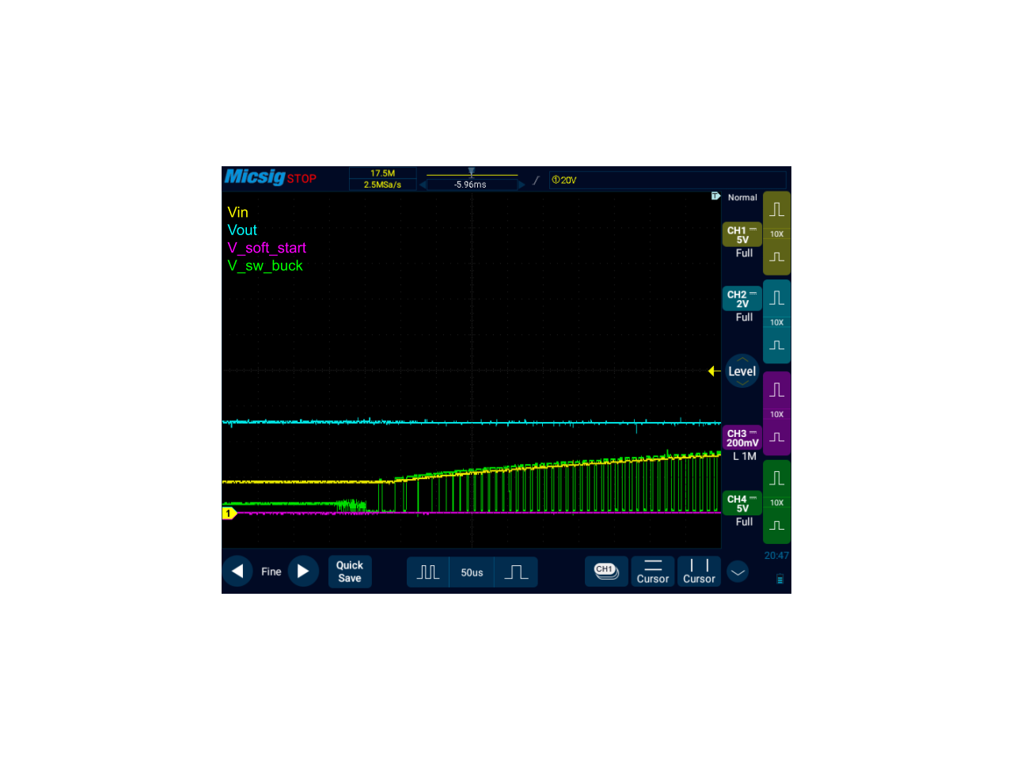
measurements/prebias startup/2026-05-07/annotated/2025-05-07 3) vin vout vsoftstart vswbuck 50us.png
