harrisonhsueh/Buck_Boost_42W/measurements/prebias startup/2026-05-07/annotated/2025-05-07 4) vin vout vghbuck-vswbuck vswbuck 200ms.png

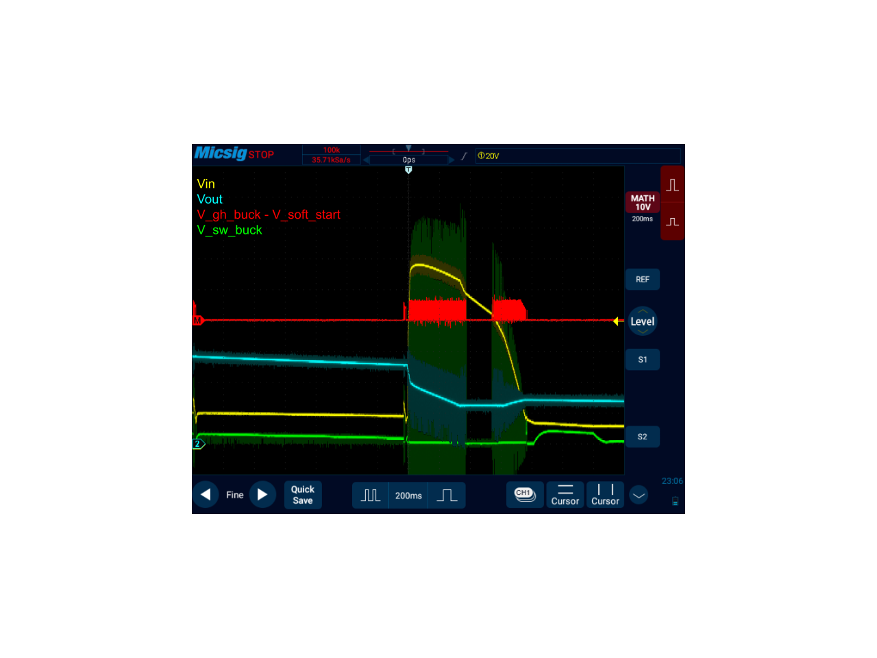
measurements/prebias startup/2026-05-07/annotated/2025-05-07 4) vin vout vghbuck-vswbuck vswbuck 200ms.png
