harrisonhsueh/Buck_Boost_42W/measurements/prebias startup/2026-05-07/annotated/2025-05-07 5) vin vout vghbuck-vswbuck vswbuck 5ms.png

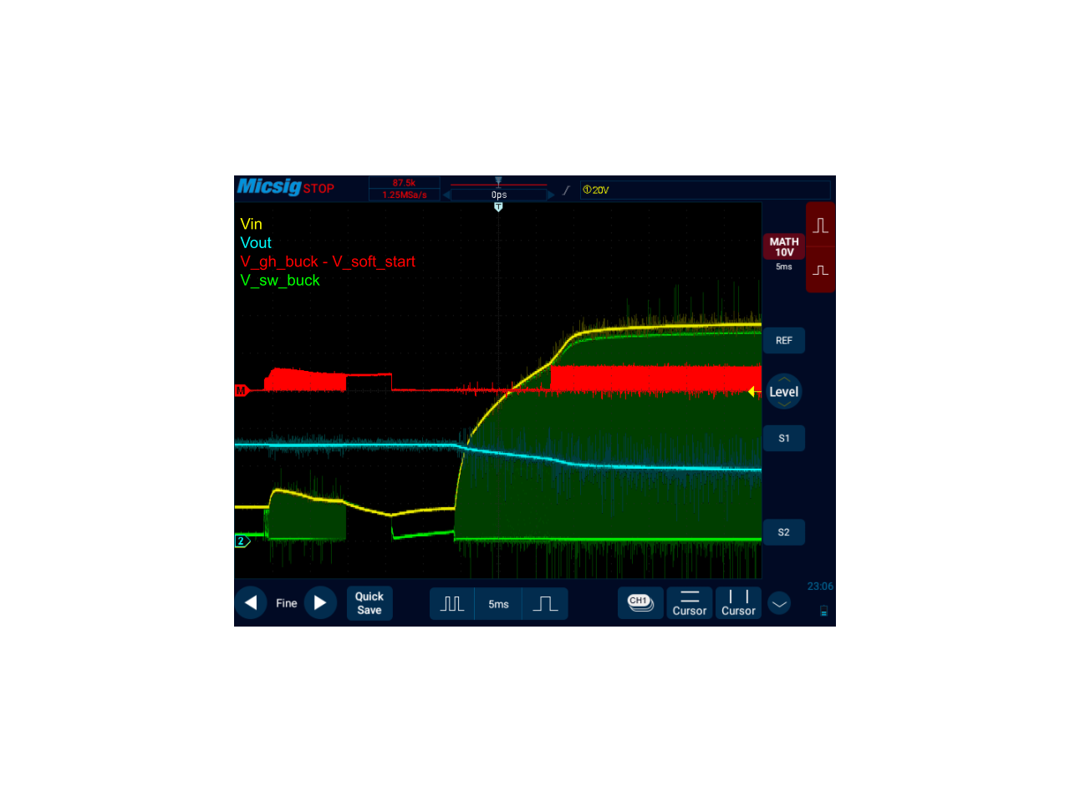
measurements/prebias startup/2026-05-07/annotated/2025-05-07 5) vin vout vghbuck-vswbuck vswbuck 5ms.png
