harrisonhsueh/Buck_Boost_42W/measurements/prebias startup/2026-05-07/Screenshot_2026-05-07-20-41-10.png

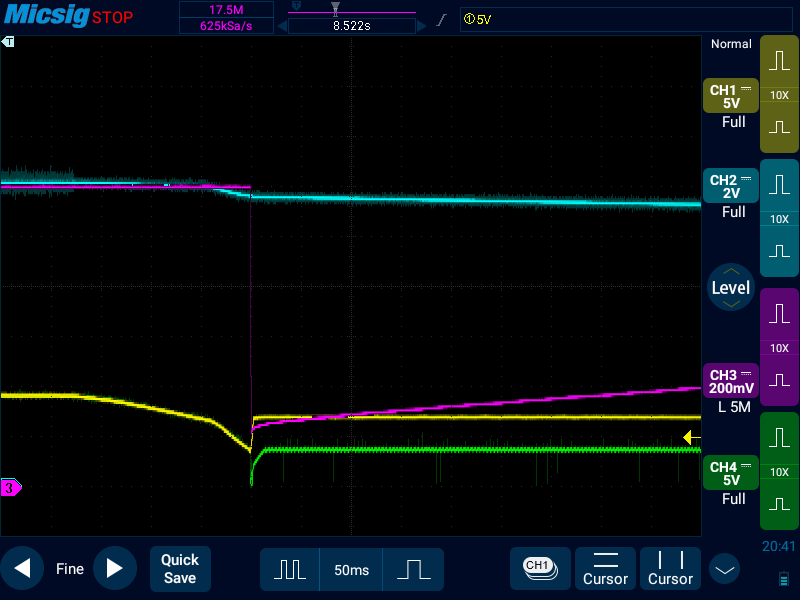
measurements/prebias startup/2026-05-07/Screenshot_2026-05-07-20-41-10.png
