harrisonhsueh/Buck_Boost_42W/measurements/prebias startup/2026-05-07/Screenshot_2026-05-07-20-54-57.png

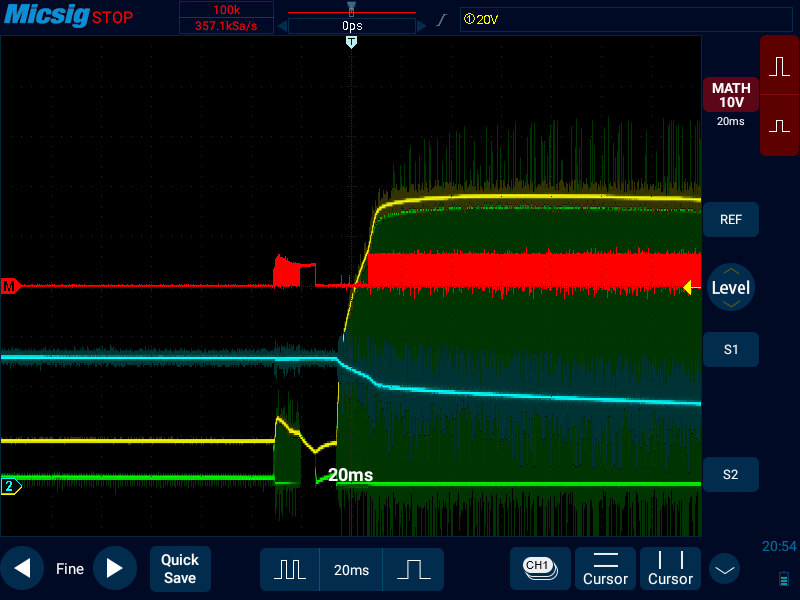
measurements/prebias startup/2026-05-07/Screenshot_2026-05-07-20-54-57.png
