harrisonhsueh/Buck_Boost_42W/measurements/prebias startup/2026-05-13 pulse vin/2026-05-13 Measurements Annotated/2025-05-13 5) vin vout vghbuck-vswbuck vswbuck 100ms.png

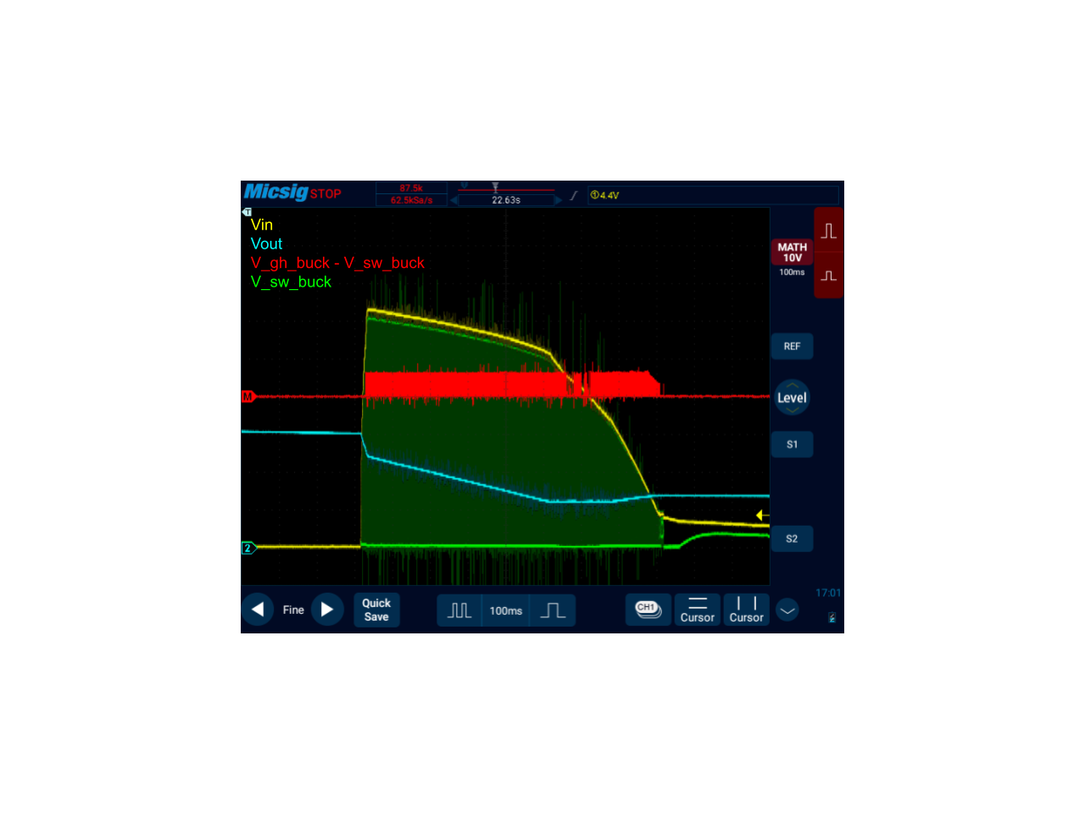
measurements/prebias startup/2026-05-13 pulse vin/2026-05-13 Measurements Annotated/2025-05-13 5) vin vout vghbuck-vswbuck vswbuck 100ms.png
