harrisonhsueh/Buck_Boost_42W/measurements/prebias startup/2026-05-13 pulse vin/Screenshot_2026-05-13-14-55-08.png

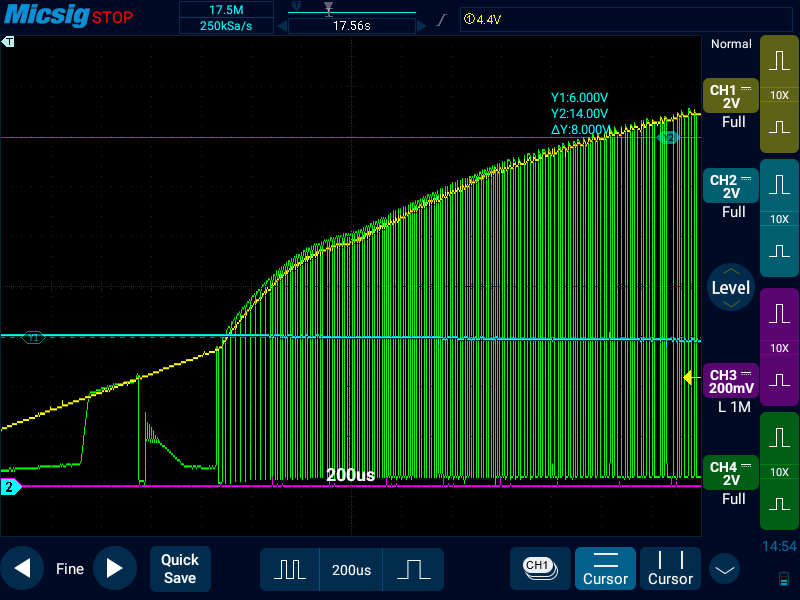
measurements/prebias startup/2026-05-13 pulse vin/Screenshot_2026-05-13-14-55-08.png
