harrisonhsueh/Buck_Boost_42W/datasheets/inductors/TDK ERU/eru-lt-wi-en-zip/History.txt

History for SPICE-Library for LTspice (Linear Technologies)
for TDK Electronics AG : ERU.lib
Version 1.25
assembled on (Mon May  6 13:44:05 CEST 2024)

-----------------------------------------------------------------------
Version 1.25
-	B82579A-A033 - ERU33M added

-----------------------------------------------------------------------
Version 1.20
-	B82579A-A027 - ERU27M powder core added

-----------------------------------------------------------------------
Version 1.15
-	B82559A-A033 - ERU33 added

-----------------------------------------------------------------------
Version 1.10
-	B82559A-A013 - ERU13 added
	B82559A-A020 - ERU20 added
	B82559A-A025 - ERU25 added

-----------------------------------------------------------------------
Version 1.00
-	library created
	B82559B-A016 - ERU16 added
	B82559B-A019 - ERU19 added
	B82559A-A024 - ERU24 added
	B82559B-A027 - ERU27 added

-----------------------------------------------------------------------
