harrisonhsueh/Buck_Boost_42W/simulation/input_bounce_test_setup.asc

C1: cap; 200µ
ESP32: voltage; PWL(0 0 105m 0 105.1m 3.3 105.2m 3.3 105.3m 0)
I1: current; PWL(0 0 107m 0 107.1m 5 107.6m 5 107.7m 0)
M1: pmos; IRF7406
M2: pmos; IRF7406
Q1: npn; 2N3904
Q2: npn; 2N3904
R1: res; 10k
R2: res; 10k
R3: res; 10k
R4: res; 100
R5: res; 10k
R6: res; 40k
R8: res; 10k
R9: res; 10k
V1: voltage; PWL(0 0 1m 0 5m 6 80m 6 100m 0 200m 0 300m 6)
V2: voltage; PWL(0 0 1m 0 5m 0 50m 12 100m 12 120m 0)
V4: voltage; 9
Named nets: 0, VIN_PS, VIN, VOUT, VOUT_DIV
.tran 300m
EN/UVLO
LM5176 DC-DC Controller
Latching Circuit
