harrisonhsueh/Buck_Boost_42W/simulation/en_uvlo_lockoutv2.asc

Q1: npn; 2N3904
Q2: npn; 2N3904
Q3: npn; 2N3904
Q4: pnp; 2N3906
R1: res; 100k
R2: res; 300k
R3: res; 1k
R4: res; 4.9k
R5: res; 5k
R6: res; 150k
R7: res; 5k
R8: res; 30k
R9: res; 2k
V1: voltage; PWL(0 0 1m 0 5m 6 80m 6 100m 0 200m 0 300m 6)
V2: voltage; PWL(0 0 1m 0 5m 0 50m 12 100m 12 120m 0)
V3: voltage; PWL(0 0 1m 0 5m 6 60m 6 70m 0 80m 0 90m 6)
Named nets: 0, VIN, EN_UVLO, VB1, VB3, VB2P, VOUT
.tran 300m
EN/UVLO
LM5176 DC-DC Controller
Latching Circuit
