harrisonhsueh/Buck_Boost_42W/simulation/en_uvlo_lockoutv3_tlv.asc

B1: bi; I=if(V(EN_UVLO,0) < 1.22, if(V(EN_UVLO,0) < 0.82,0,0.2u), 3.15u)
Q1: npn; 2N3904
Q2: pnp; 2N3906
Q3: npn; 2N3904
Q4: pnp; 2N3906
R1a: res; 150k
R1b: res; 15k
R2: res; 420k
R3: res; 130k
R4: res; 300k
R5: res; 82k
R6: res; 1k
R7: res; 30k
R8: res; 2Meg
R9: res; 2.2k
R10: res; 39k
R11: res; 100k
R12: res; 100k
U1: TLV431
V1: voltage; PWL(0 0 1m 0 5m 6 80m 6 100m 0 200m 0 300m 6)
V2: voltage; PWL(0 0 1m 0 5m 0 50m 12 100m 12 120m 0)
V3: voltage; PWL(0 0 1m 0 5m 6 60m 6 70m 0 80m 0 90m 6)
Named nets: 0, VIN, EN_UVLO, VB3, VB4P, VOUT, VREF
.tran 0 150m 0 1e-7
EN/UVLO
LM5176 DC-DC Controller
Latching Circuit
