harrisonhsueh/Buck_Boost_42W/(list of files, drawings)

Other design files:
datasheets/inductors/TDK ERU/eru-ps-wi-en-zip/ERU.olb
