harrisonhsueh/Buck_Boost_42W/(commit log)

2026-02-03 Add loss calculations and inductors and mosfets Missing ac/core losses for some series Added datasheets and some LTSpice files
    [ERU.olb, inductors.csv, mosfets.csv]
2026-02-03 Updated TDK inductors with AC losses Cleaned up inductor code section Choosing 2013 based on Wurth calculator, documented in google docs for now
    [inductors.csv]
2026-02-03 Calculations to compare different mosfets at P_out = 13.5W
    [mosfets.csv]
2026-02-04 Small fixeds to initial calcs and added a design specific calculation Realized fan load is no dc given it is a motor and result in double peak power requirement at relatively low frequency
2026-02-14 Scope measurement of fan startup load
    [Scope_P14Pro_Startup_Current_1r57_shunt.csv]
2026-02-14 Added scope measurement for sudden stop of fans
    [Scope P14Pro_Stop_Current_1r57_shunt.csv, Scope P14Pro_Stop_PWM_input.csv, Scope_P14Pro_Startup_Current_1r57_shunt.csv, Scope_P14Pro_Startup_PWM_input.csv]
2026-02-14 updated calculations and added output and input capacitor calculations
2026-02-21 updated cout calculations and method added some single fan startup data
    [0908310013.csv, 0908310014.csv, 0908310015.csv, 0908310016.csv, 0908310017.csv, 0908310018.csv, 0908310019.csv, 0908310020.csv]
2026-02-22 update to measured data for startup current
2026-04-11 updates to calculations. update to some parts based on parts availability. first pcb revision sent out for manufacturing.
    [Scope_P14Pro_Startup_Current_1r57_shunt.csv, Scope_P14Pro_Startup_Current_1r57_shunt_full.csv, Scope_P14Pro_Startup_Current_1r57_shunt_trunc.csv, Scope_P14Pro_Startup_PWM_input.csv, Scope_P14Pro_Startup_PWM_input_full.csv, Scope_P14Pro_Startup_PWM_input_trunc.csv, efficiency_analysis.csv, inductors.csv]
2026-04-11 time domain simulation of existing circuit to check and potentially redesign controller
2026-04-12 attempting time domain startup simulation for existing design. currently shows instability
2026-04-12 fixed control logic with valley switching
2026-04-13 trying to see how to slightly modify v1 circuit to be stable. tried directly driving ss pin current externally, but didnt help. next try to directl drive ss pin voltage
2026-04-17 time domain analysis largely updated. adaptive time step implemented. small issue with step size causing artifacts though. updated bode plots for stability as well to include accurate gain and multip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
2026-04-18 updates to bode plots. power stage, changing vin and power for boost mode.
2026-05-04 cleanup constants. will need to redo all notebooks to used shared constants and design parameters
    [capacitors.csv, inductors.csv, inductors_old.csv, inductors_old2.csv, mosfets.csv]
2026-05-12 esp32 arduino ide test to simulate input chatter
2026-05-14 rework vin diode and cap and test setup simulation and measurements with intermittent vin
2026-05-14 calibrated and used esp32 input pmos switch circuit with 11v and 6v threshold
2026-06-21 new circuit topology and checking resistor values for one portion
2026-09-12 updates to uvlo latch circuit analysis
    [0908310013.csv, 0908310014.csv, 0908310015.csv, 0908310016.csv, 0908310017.csv, 0908310018.csv, 0908310019.csv, 0908310020.csv]
2026-09-14 updating inductor part info for loss and pricing
    [inductor_losses_measured.csv, inductors.csv, mosfets.csv]
2026-09-14 updates do inductor loss from Wurth calculator, some inductor part pricing, udpates to readme and claude.md
    [inductor_losses_measured.csv, inductors.csv, mosfets.csv]
2026-09-14 updates to inductor to include more families with manufacturer calculator data. v1 choice still holds only for reason of availability on jlcpcb stocked parts
    [inductor_losses_measured.csv, inductors.csv]
2026-09-15 update mosfet datasheet extracted values, some had erros. updated mosfet and inductor notebooks
    [mosfet_figure_reads.csv, mosfets.csv]
2026-09-15 ran efficiency test 5v input 3 arctic p14 fans
    [2026-09-15_114836_fans_5V.csv]
2026-09-15 update efficiency test to measure speed. added plot of efficiency with 3 fan p14 test
2026-09-15 added calibration script for shunt
2026-09-15 measured calibration data for shunt and 10 fan load efficiencies
    [2026-09-15_115614_fans_9V.csv, 2026-09-15_132554_shunt_cal_in.csv, 2026-09-15_133151_shunt_cal_in.csv, 2026-09-15_135055_shunt_cal_fan12_fan1_fan2_fan3.csv, 2026-09-15_140050_fans_5V.csv, 2026-09-15_140201_fans_5V.csv, 2026-09-15_140503_fans_9V.csv, 2026-09-15_141025_fans_15V.csv]
2026-09-15 processed calibration and efficiency data. need to retake 5v adn 9v efficiencies
    [2026-09-15_132554_shunt_cal_in.csv, 2026-09-15_efficiency_summary.csv]
2026-09-15 reran 5v and 9v efficiencies
    [2026-09-15_151050_fans_5V.csv, 2026-09-15_151326_fans_5V.csv, 2026-09-15_151441_fans_5V.csv, 2026-09-15_151555_fans_5V.csv, 2026-09-15_151955_fans_9V.csv]
2026-09-15 redid 12v fan shunt calibration with both jumpers
    [2026-09-15_154613_shunt_cal_fan12.csv]
2026-09-19 updates to efficiency measurement calculations, created presentation and todo list
    [2026-09-15_efficiency_summary.csv, BOM-BUCK_BOOST_42W_V1P4_removed_nm - BOM-BUCK_BOOST_42W.csv]
2026-10-12 data with load resistors instead of fans
